123-code/gpu_design/docs/architecture.png

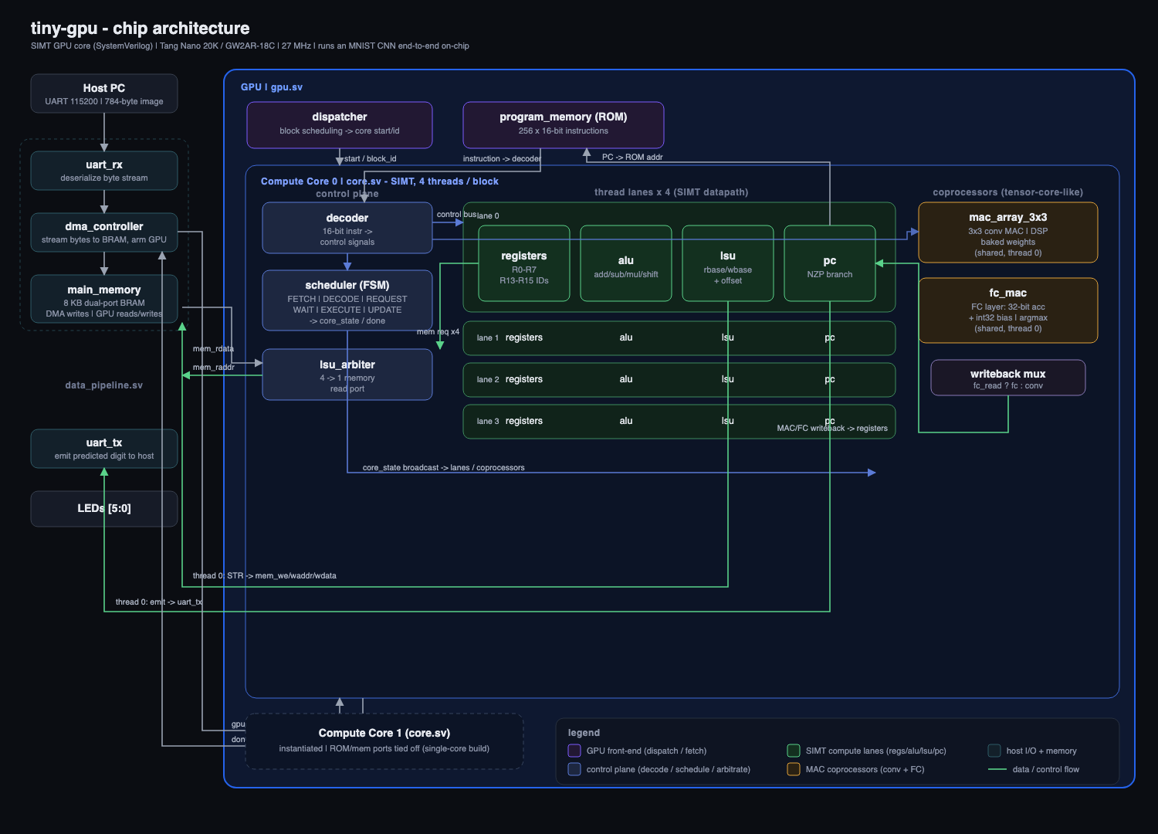
docs/architecture.png
