123-code/gpu_design/docs/core_detail.png

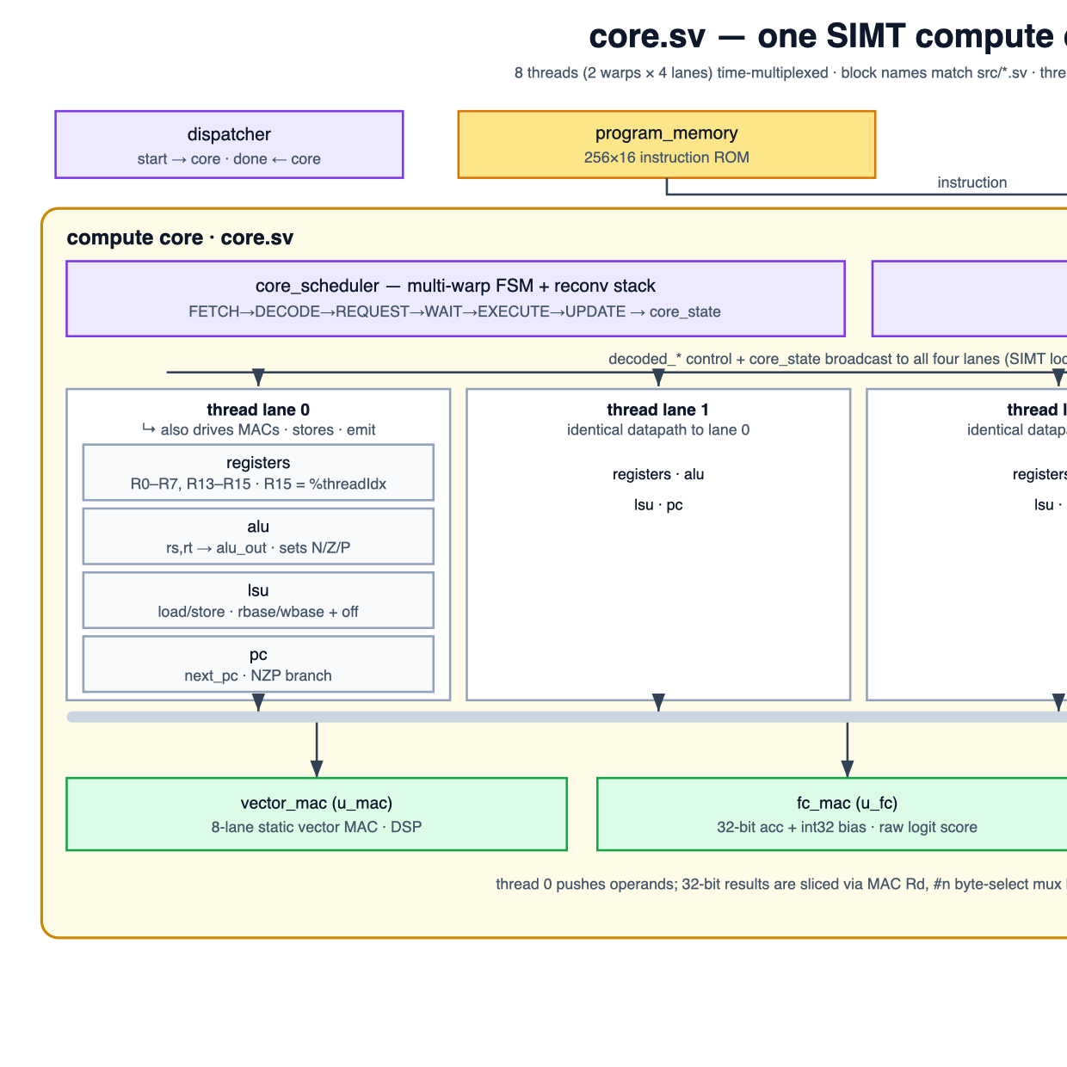
docs/core_detail.png
