123-code/gpu_design/docs/demo.png

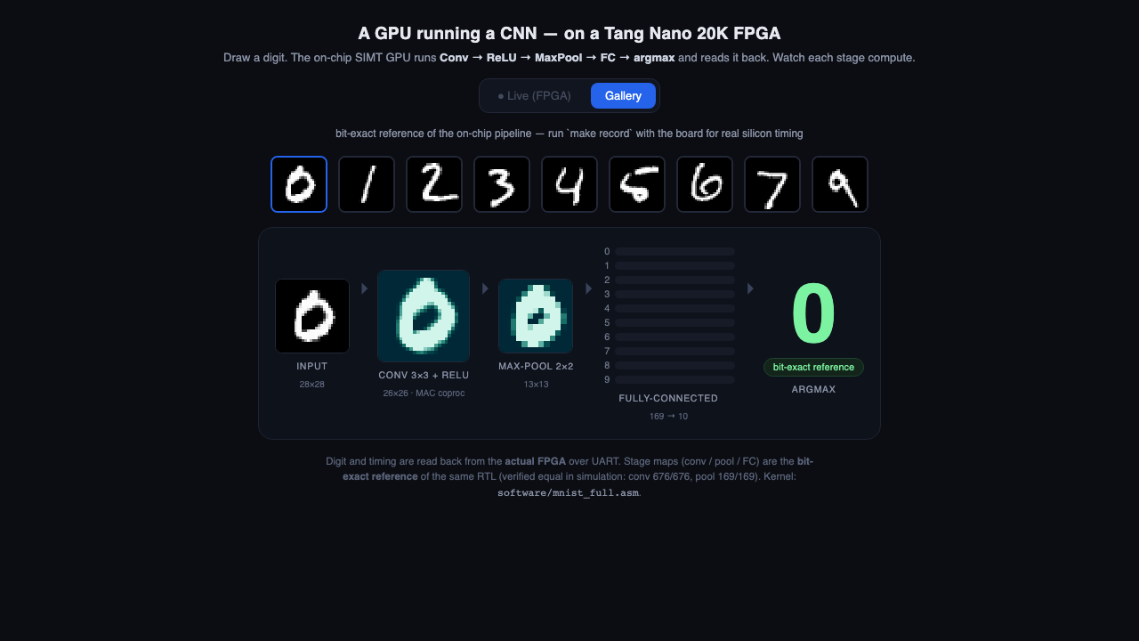
docs/demo.png
