123-code/gpu_design/docs/floorplan.svg.png

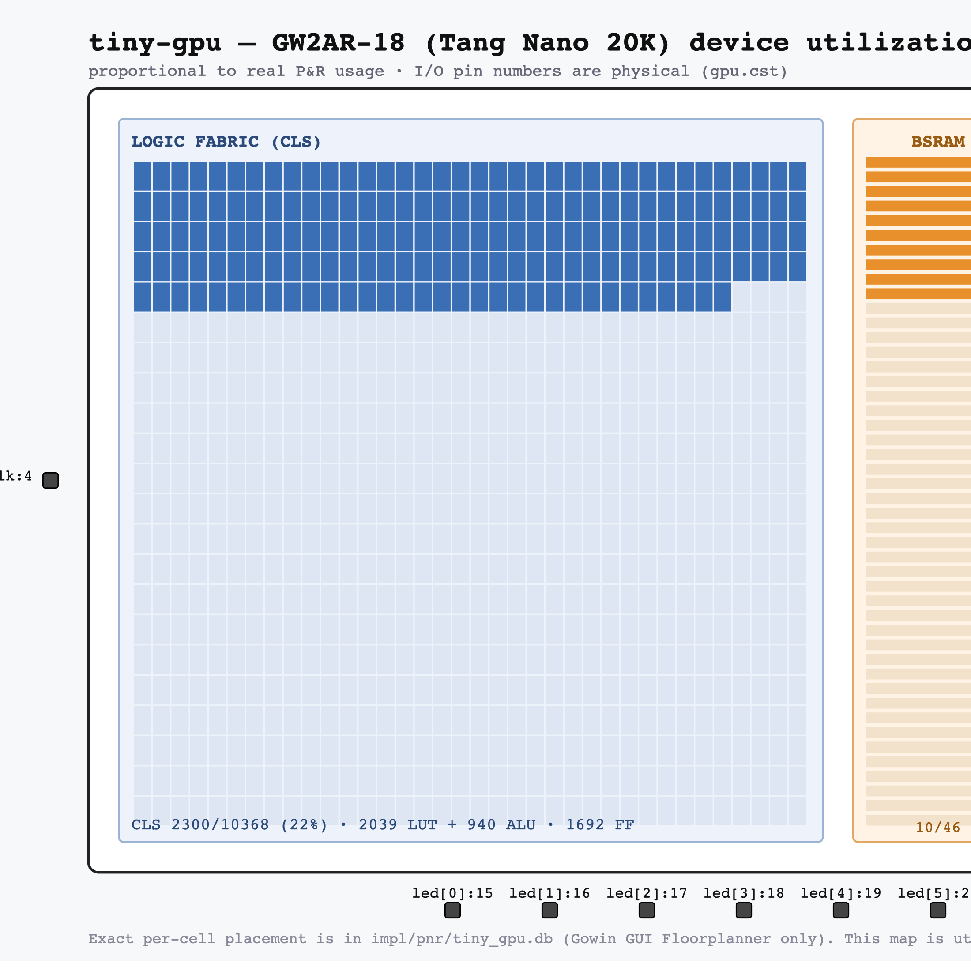
docs/floorplan.svg.png
