123-code/gpu_design/docs/gpu_overview.png

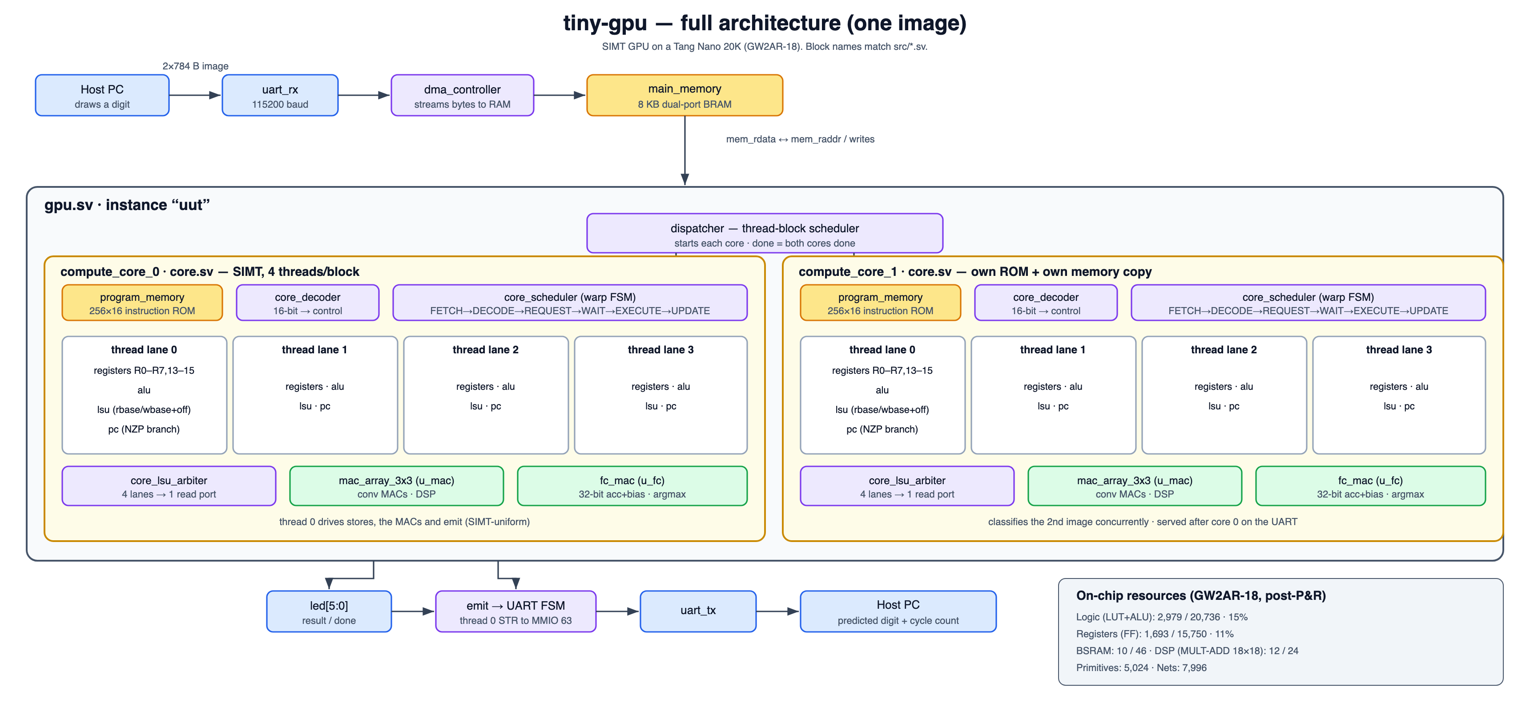
docs/gpu_overview.png
