123-code/gpu_design/docs/schematic/core_gates_flat.svg.png

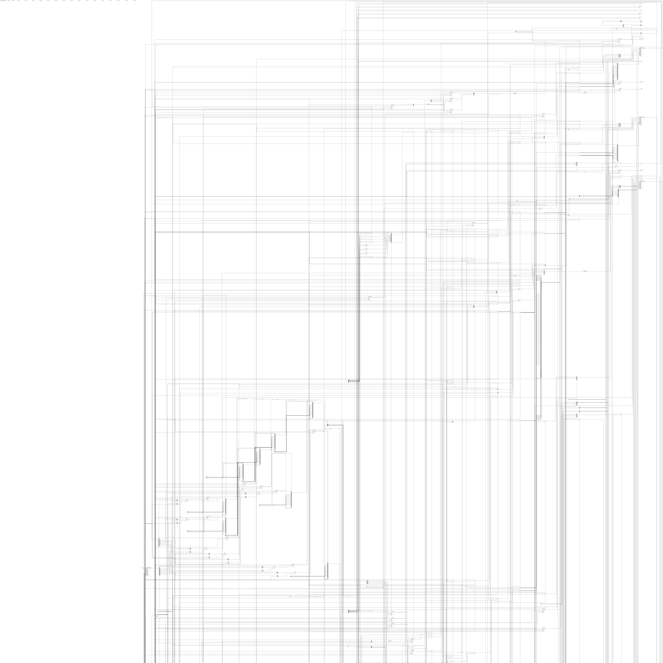
docs/schematic/core_gates_flat.svg.png
