123-code/gpu_design/docs/schematic/png/core.svg.png

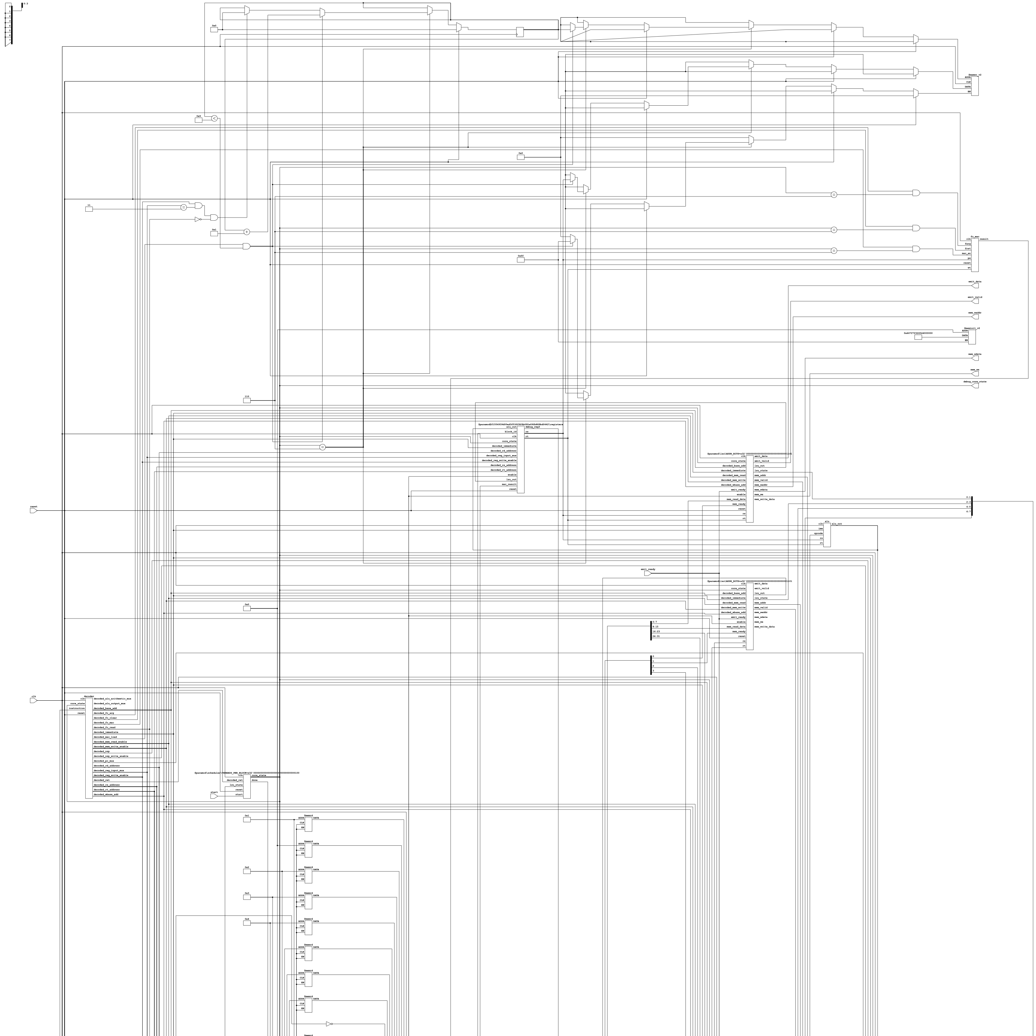
docs/schematic/png/core.svg.png
