123-code/gpu_design/docs/schematic/png/gate_alu.svg.png

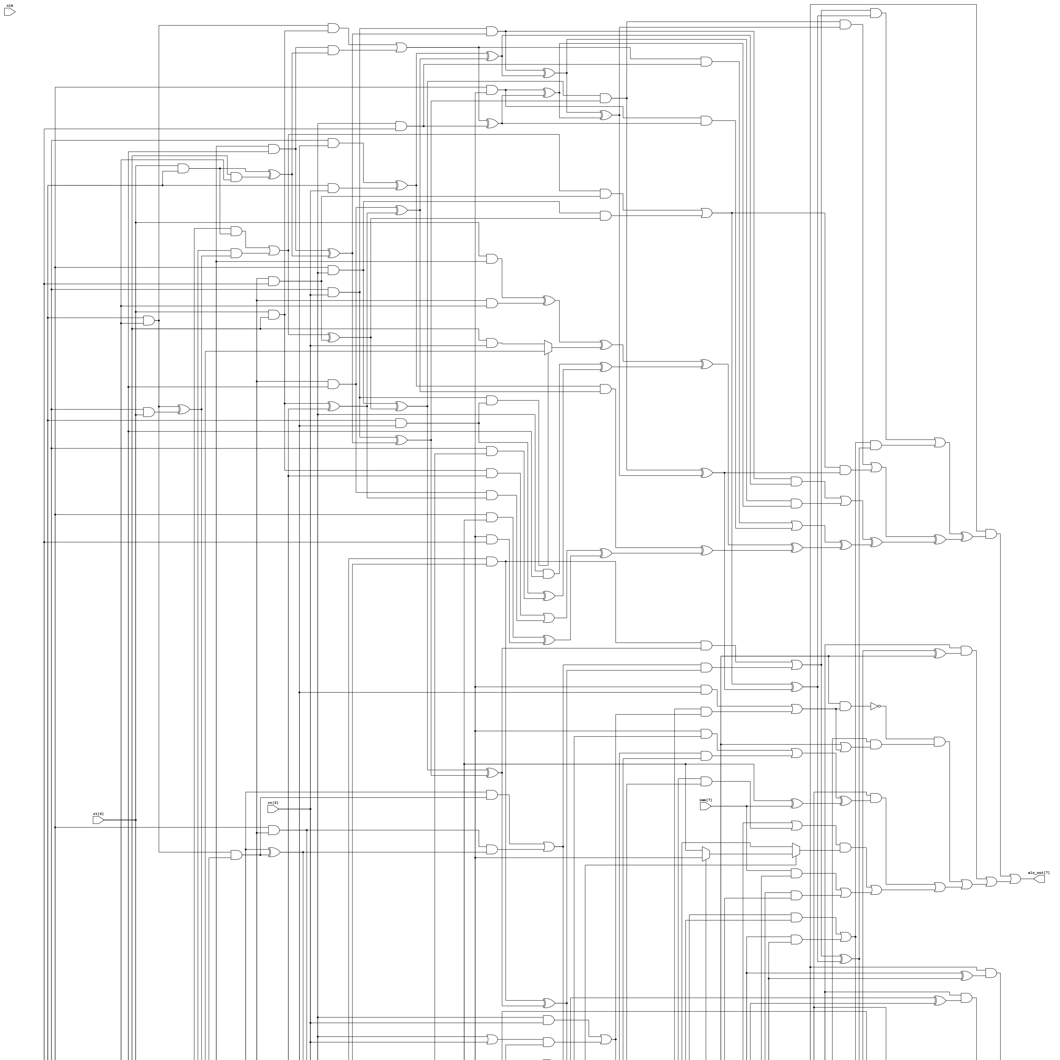
docs/schematic/png/gate_alu.svg.png
