123-code/gpu_design/docs/schematic/png/gate_pc.svg.png

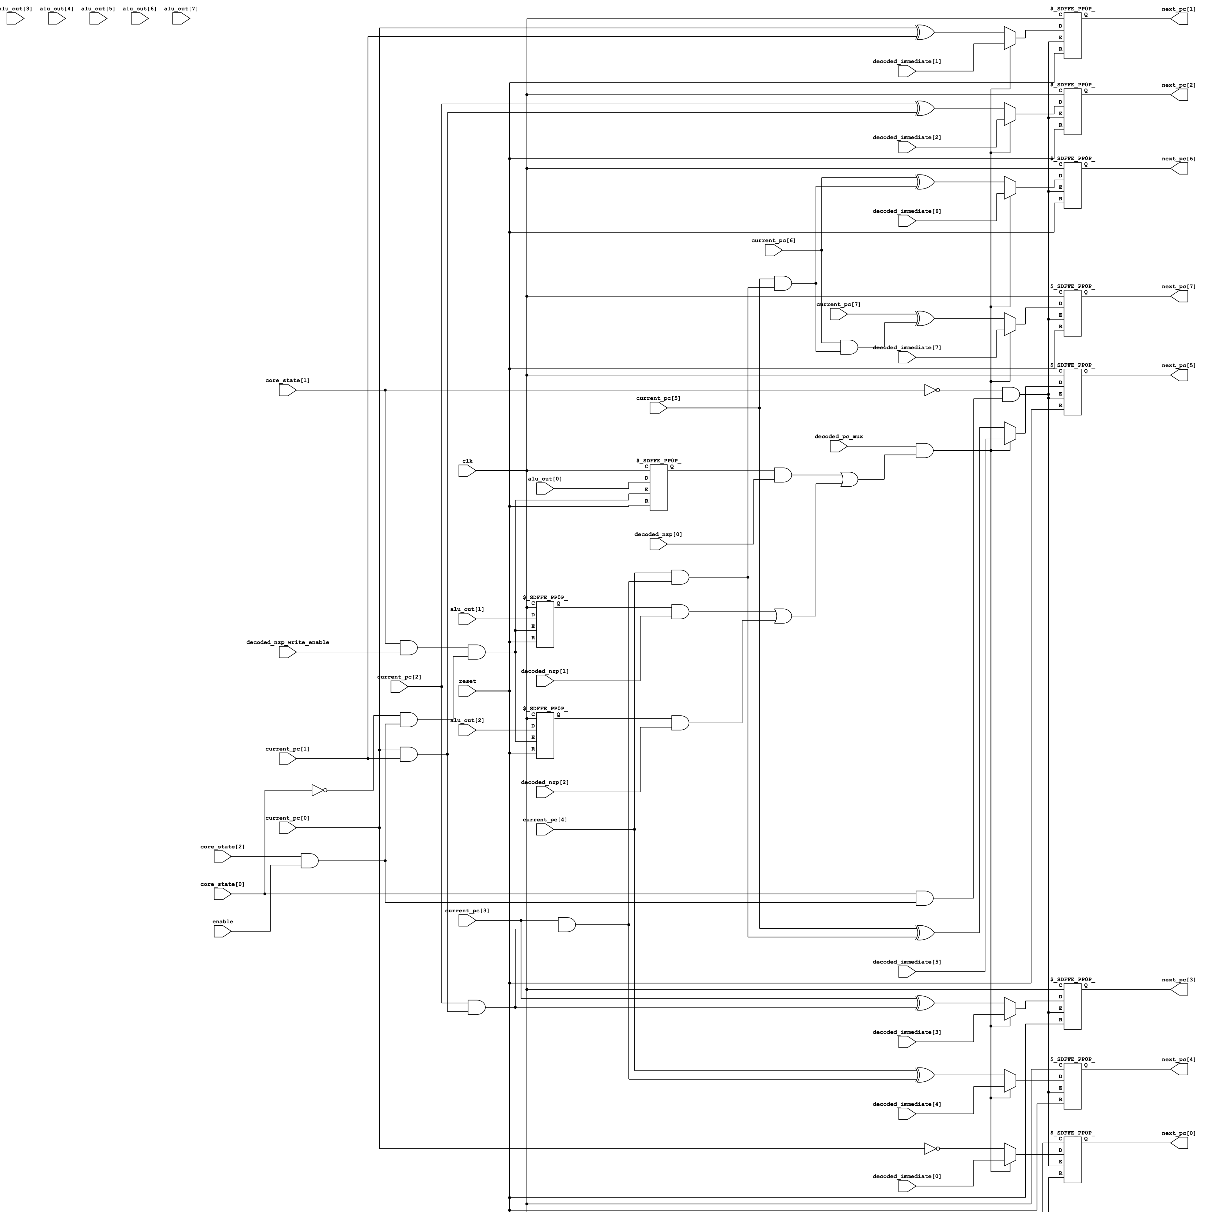
docs/schematic/png/gate_pc.svg.png
