123-code/gpu_design/docs/schematic/png/gate_scheduler.svg.png

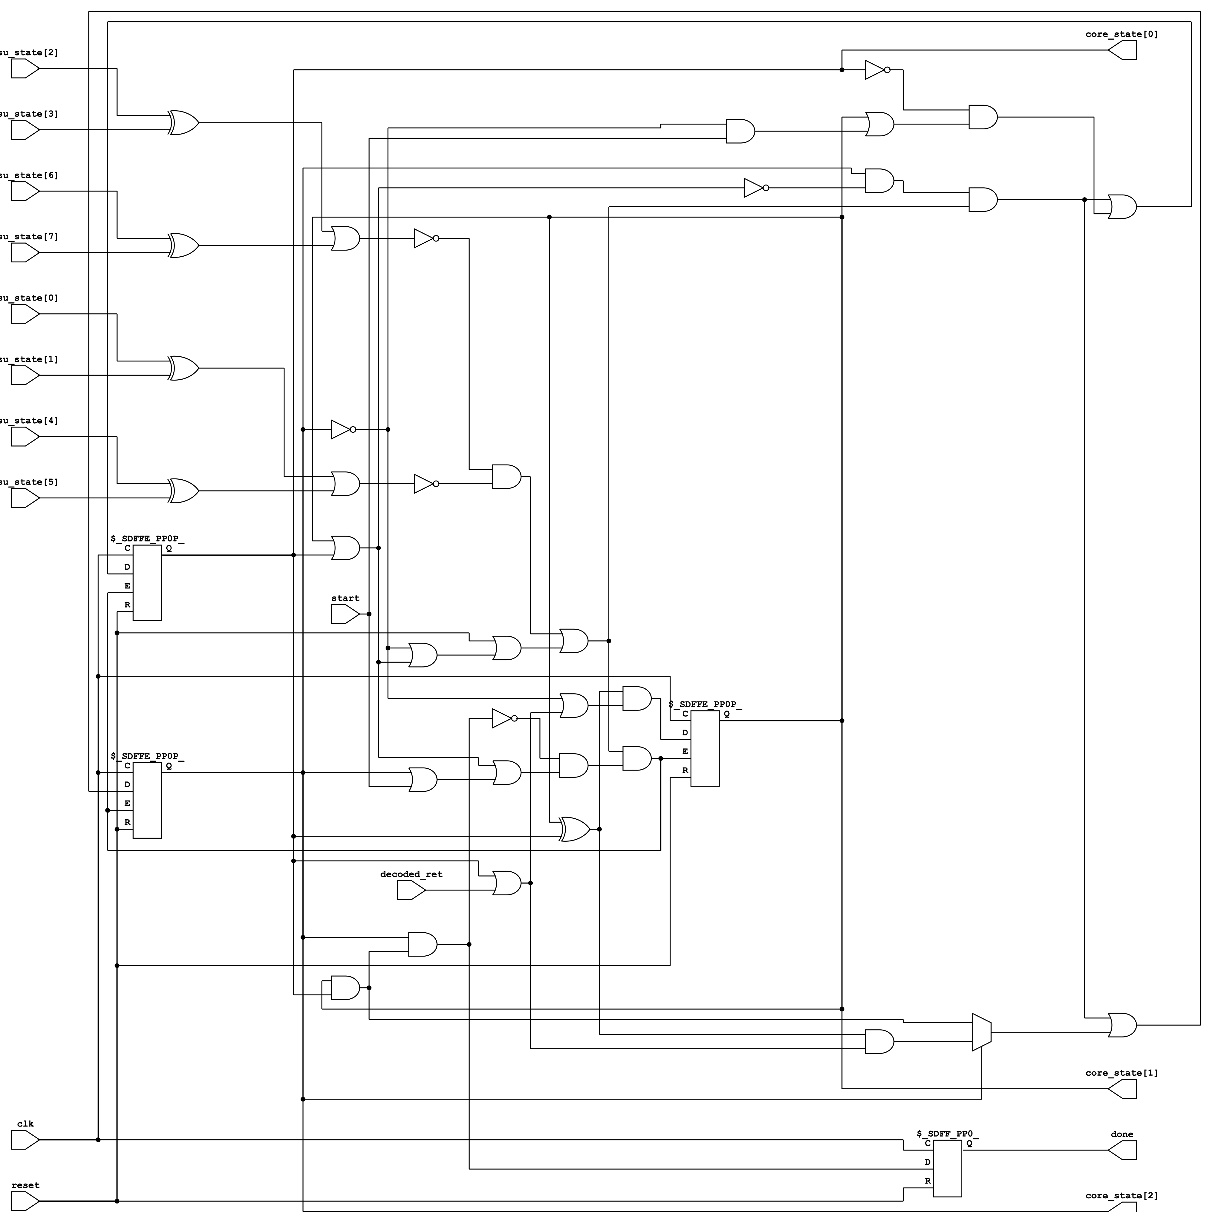
docs/schematic/png/gate_scheduler.svg.png
