123-code/gpu_design/docs/schematic/png/gpu.svg.png

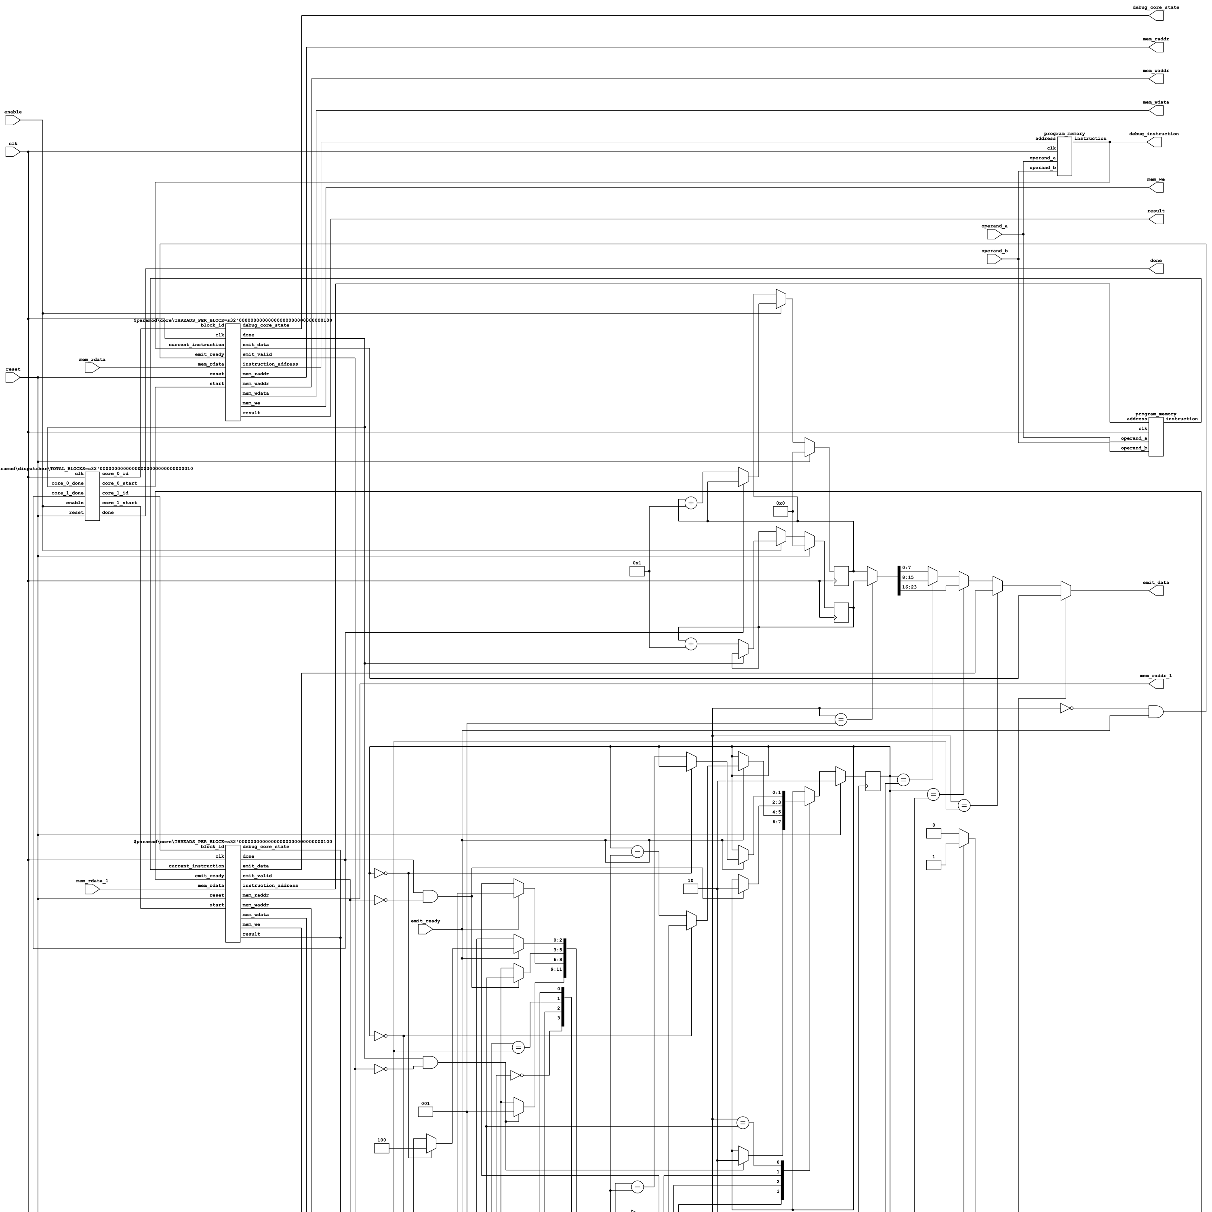
docs/schematic/png/gpu.svg.png
