123-code/gpu_design/docs/schematic/png/top.svg.png

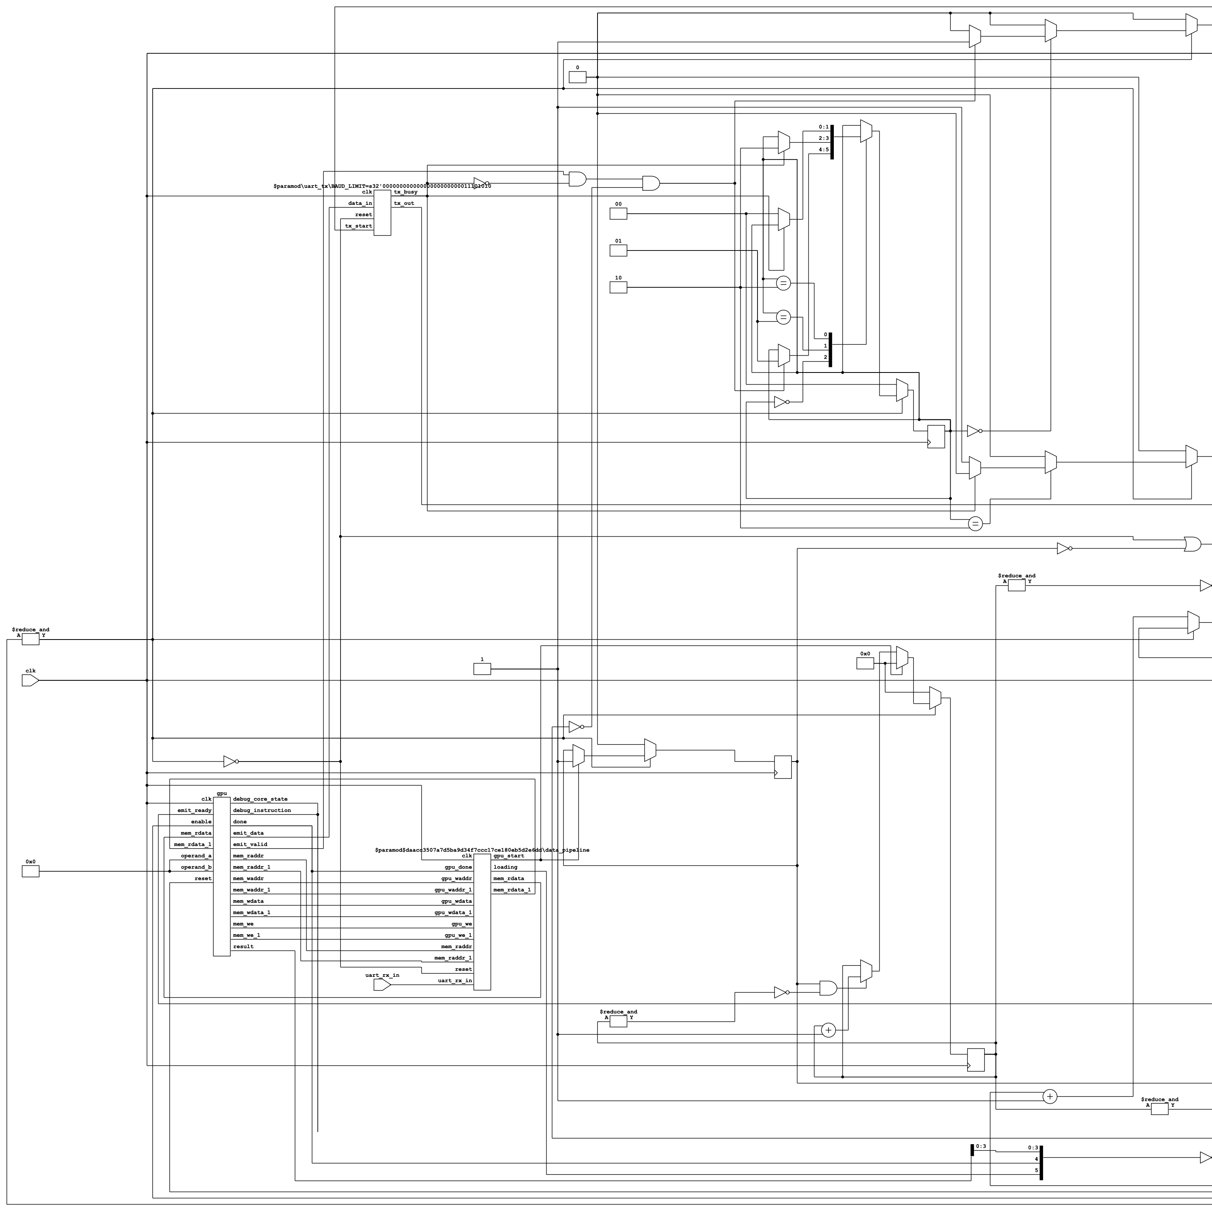
docs/schematic/png/top.svg.png
