123-code/gpu_design/src/main_memory.sv

`default_nettype none
`timescale 1ns/1ns

// Main data memory the GPU threads read from, and the DMA writes into.
// Simple dual-port BRAM: one write port (driven by the DMA while loading),
// one synchronous read port (driven by a thread's LSU). Gowin infers this as
// a semi-dual-port BSRAM. 1-cycle read latency.
module main_memory #(
    parameter ADDR_BITS     = 13,            // 4096 bytes: image + conv/FC weights +
                                         // GPU-computed conv/pool/score scratch.
                                         // Maps to ~2-4 BSRAM blocks (of 46).
    parameter DEPTH     = (1 << ADDR_BITS)
) (
    input  wire                 clk,

    // ---- write port (DMA) ----
    input  wire                 we,
    input  wire [ADDR_BITS-1:0] waddr,
    input  wire [7:0]           wdata,

    // ---- read port (GPU) ----
    input  wire [ADDR_BITS-1:0] raddr,
    output reg  [7:0]           rdata
);
    reg [7:0] mem [0:DEPTH-1];

    // NO baked model. This memory used to $readmemh 3380 bytes of interleaved
    // MNIST FC weights at synthesis time, which meant changing the network meant
    // re-synthesizing the bitstream -- the model was part of the hardware.
    //
    // Every weight now arrives over UART as data, planned and packed by the
    // compiler (software/src/bin/graph_compiler.rs). The bitstream is
    // model-independent. Nothing depended on the baked copy: each testbench
    // already streamed its own payload, and the DMA overwrote these addresses
    // before the kernel read them.

    always @(posedge clk) begin
        if (we) mem[waddr] <= wdata;     // DMA / GPU store
        rdata <= mem[raddr];             // synchronous read (1-cycle latency)
    end
endmodule
