123-code/gpu_design/src/decoder.sv

`default_nettype none
`timescale 1ns/1ns

module decoder #(
    parameter DATA_BITS = 16     // datapath width; sizes decoded_immediate
) (
    // ==========================================
    // PART 1: THE INPUT PINS (Wires coming IN)
    // ==========================================
    input wire clk,              // The heartbeat of the system (27MHz on the Tang Nano)
    input wire reset,            // The physical reset button/signal

    input wire [3:0] core_state,
    input wire [15:0] instruction,
    
    // ==========================================
    // PART 2: THE OUTPUT PINS (Wires going OUT)
    // ==========================================
    // Group A: Data Slices (routing chunks of the instruction to other places)
    output reg [3:0] decoded_rd_address,
    output reg [3:0] decoded_rs_address,
    output reg [3:0] decoded_rt_address,
    output reg [2:0] decoded_nzp,
    output reg [DATA_BITS-1:0] decoded_immediate,
    
    // Group B: Control Flags (1-bit boolean wires turning other components ON/OFF)
    output reg decoded_reg_write_enable,           
    output reg decoded_mem_read_enable,            
    output reg decoded_mem_write_enable,           
    output reg decoded_nzp_write_enable,           
    
    // Group C: Multiplexers (Multi-bit wires telling components HOW to behave)
    output reg [1:0] decoded_reg_input_mux,
    output reg [1:0] decoded_alu_arithmetic_mux,
    output reg decoded_alu_output_mux,
    output reg decoded_pc_mux,
    output reg decoded_ret,

    // MAC unit control: push an operand into the MAC buffer this instruction
    output reg decoded_mac_load,

    // Address unit: add decoded_immediate to the LSU read base this instruction
    output reg decoded_base_add,
    // ... or to the LSU write base (WBASE = ADDB with instruction[11] set)
    output reg decoded_wbase_add,

    // FC-MAC coprocessor control (opcode 0000 sub-functions)
    output reg decoded_fc_clear,   // FRST : reset the FC engine (acc/digit/best)
    output reg decoded_fc_mac,     // FMAC : acc += rs*rt
    output reg decoded_fc_arg,     // FARG : finalize current digit (add bias, argmax)
    output reg decoded_fc_read,    // FBEST: rd <- best_idx (uses the MAC writeback mux)
    output reg decoded_fc_acc,     // FACC : rd <- byte n of the raw accumulator
    output reg decoded_fc_out,     // FOUT : rd <- requantized+ReLU'd neuron output
    output reg [2:0] decoded_fc_shift, // FOUT : extra right shift beyond 8

    // Which 8-bit slice of the 32-bit MAC/FC result to write back (MAC Rd,#n).
    // 0 = [7:0] (LSB) ... 3 = [31:24] (MSB). 0 for every non-MAC instruction.
    output reg [1:0] decoded_mac_byte,

    // identity register (R15/R13/R14) into rd. The selector reuses the rs field
    // (decoded_rs_address): 1->threadIdx, 2->blockIdx, 3->blockDim.
    output reg decoded_id_read,

    // LUI (MOV-variant, rs field == 4): Rd = (Rd << 6) | imm6. Lets software build
    // a full 16-bit constant in 3 ops (MOV top4 + LUI mid6 + LUI low6). Computed in
    // the register file (no ALU/opcode change); the decoder points rs at Rd so the
    // regfile latches the old Rd to shift.
    output reg decoded_lui,
    
    // Pop the reconvergence stack and switch to sleeping threads
    output reg decoded_sync
);

    // Human-readable labels for the physical 4-bit Opcode wire combinations
    localparam FCU  = 4'b0000; // FC-MAC coprocessor; sub-function in instruction[5:4]
    localparam ADD  = 4'b0001;
    localparam MOV  = 4'b0010;
    localparam CMP  = 4'b0011;
    localparam LDR  = 4'b0100;
    localparam ADDI = 4'b0101;
    localparam MUL  = 4'b1010; // general arithmetic primitives (rd = rs op rt)
    localparam SHR  = 4'b1100;
    localparam SHL  = 4'b1101;
    localparam SUB  = 4'b1110;
    localparam MACL = 4'b0110; // push a register into the MAC operand buffer
    localparam MAC  = 4'b0111; // fire the MAC, write result to rd
    localparam BRn  = 4'b1000;
    localparam ADDB = 4'b1001; // base += immediate (data-memory base pointer)
    localparam STR  = 4'b1011; // store/emit: write rt to [rs] (MMIO TX when rs==63)
    localparam RET  = 4'b1111;

    // decoded_reg_input_mux selectors (must match registers.sv)
    localparam MUX_ARITHMETIC = 2'b00;
    localparam MUX_MEMORY     = 2'b01;
    localparam MUX_CONSTANT   = 2'b10;
    localparam MUX_MAC        = 2'b11;

    // ==========================================
    // PART 3: THE INTERNAL LOGIC MACHINERY
    // ==========================================
    // This block tells the hardware: "Every time the 'clk' pin voltage goes from LOW to HIGH, do this."
    always @(posedge clk) begin 
        
        // If the reset pin is triggered, turn all output wires OFF (0 Volts)
        if (reset) begin
            decoded_rd_address <= 0;
            decoded_rs_address <= 0;
            decoded_rt_address <= 0;
            decoded_nzp <= 0;
            decoded_immediate <= 0;

            decoded_reg_write_enable <= 0;
            decoded_mem_read_enable <= 0;
            decoded_mem_write_enable <= 0;
            decoded_nzp_write_enable <= 0;

            decoded_reg_input_mux <= 0;
            decoded_alu_arithmetic_mux <= 0;
            decoded_alu_output_mux <= 0;
            decoded_pc_mux <= 0;
            decoded_ret <= 0;
            decoded_mac_load <= 0;
            decoded_base_add <= 0;
            decoded_wbase_add <= 0;
            decoded_fc_clear <= 0;
            decoded_fc_mac <= 0;
            decoded_fc_arg <= 0;
            decoded_fc_read <= 0;
            decoded_fc_acc <= 0;
            decoded_fc_out <= 0;
            decoded_fc_shift <= 0;
            decoded_mac_byte <= 0;
            decoded_id_read <= 0;
            decoded_lui <= 0;
            decoded_sync <= 0;

        end else begin
            // Only decode in the DECODE stage (4-bit state = 0011)
            if (core_state == 4'b0011) begin
                
                // --- THE BIT SLICER ---
                // Physically branching wires from the 16-lane 'instruction' bus to the output pins

                // Grabbing exactly 3 bits for registers to match the assembler ISA
                decoded_rd_address <= {1'b0, instruction[11:9]}; // dest  -> [11:9]
                decoded_rs_address <= {1'b0, instruction[8:6]};  // src1  -> [8:6]
                decoded_rt_address <= {1'b0, instruction[2:0]};  // src2  -> [2:0]

                // The immediate payload is the bottom 6 bits (assembler emits 6-bit imm)
                decoded_immediate  <= {{(DATA_BITS-6){1'b0}}, instruction[5:0]};
                decoded_nzp        <= instruction[11:9];

                // Reset control wires to 0 before the switch logic applies.
                // Every strobe must be cleared here, or a flag set by one
                // instruction (e.g. pc_mux on BRn) would stick on the next one.
                decoded_reg_write_enable <= 0;
                decoded_mem_read_enable  <= 0;
                decoded_mem_write_enable <= 0;
                decoded_nzp_write_enable <= 0;
                decoded_alu_arithmetic_mux <= 0;
                decoded_alu_output_mux <= 0;
                decoded_reg_input_mux <= 0;
                decoded_pc_mux <= 0;
                decoded_ret <= 0;
                decoded_mac_load <= 0;
                decoded_base_add <= 0;
            decoded_wbase_add <= 0;
                decoded_fc_clear <= 0;
                decoded_fc_mac <= 0;
                decoded_fc_arg <= 0;
                decoded_fc_read <= 0;
                decoded_fc_acc <= 0;
                decoded_fc_out <= 0;
                decoded_fc_shift <= 0;
                decoded_mac_byte <= 0;
                decoded_id_read <= 0;
                decoded_lui <= 0;
                decoded_sync <= 0;

                // --- THE OPCODE SWITCH ---
                // Look at the top 4 wires of the instruction (bits 15, 14, 13, 12)
                case (instruction[15:12])
                    FCU: begin
                        // FC-MAC coprocessor. Sub-function in instruction[5:4]:
                        //   00 FRST  -> reset the FC engine
                        //   01 FMAC  -> acc += rs*rt          (rs=[8:6], rt=[2:0])
                        //   10 FARG  -> finalize digit (add bias, argmax)
                        //   11 FBEST -> rd <- best_idx via the MAC writeback mux
                        case (instruction[5:4])
                            2'b00: decoded_fc_clear <= 1;
                            2'b01: decoded_fc_mac   <= 1;
                            2'b10: begin
                                // instruction[3] splits this slot:
                                //   0 = FARG (finalize a CLASSIFIER digit: add
                                //       bias, argmax, clear acc)
                                //   1 = FOUT (finalize a HIDDEN neuron: shift,
                                //       clamp, ReLU into rd, clear acc)
                                if (instruction[3]) begin
                                    decoded_fc_out           <= 1;
                                    decoded_fc_shift         <= instruction[2:0];
                                    decoded_reg_write_enable <= 1;
                                    decoded_reg_input_mux    <= MUX_MAC;
                                    decoded_fc_read          <= 1;
                                end else begin
                                    decoded_fc_arg           <= 1;
                                end
                            end
                            2'b11: begin
                                // Read the FC unit back into rd. instruction[3]
                                // selects WHAT: 0 = best_idx (FBEST, the legacy
                                // encoding, low bits all zero), 1 = the raw 32-bit
                                // accumulator (FACC). instruction[1:0] selects
                                // which byte, reusing the MAC byte-select mux.
                                decoded_reg_write_enable <= 1;
                                decoded_reg_input_mux    <= MUX_MAC;
                                decoded_fc_read          <= 1;
                                decoded_fc_acc           <= instruction[3];
                                decoded_mac_byte         <= instruction[1:0];
                            end
                        endcase
                    end
                    ADD: begin
                        // rs + rt -> rd
                        decoded_reg_write_enable <= 1;
                    end
                    ADDI: begin
                        // rs + immediate -> rd (ALU selects imm via the opcode)
                        decoded_reg_write_enable <= 1;
                    end
                    MUL, SUB, SHR, SHL: begin
                        // General ALU ops: rd = rs (op) rt, written via ARITHMETIC mux
                        decoded_reg_write_enable <= 1;
                    end
                    MOV: begin
                        decoded_reg_write_enable <= 1;
                        // rs field ([8:6]) selects the MOV variant:
                        //   0       plain MOV: load imm6
                        //   1/2/3   TID/BID/BDIM: copy identity reg R15/R13/R14 into rd
                        //   4       LUI: Rd = (Rd<<6)|imm6 (point rs at Rd to read it)
                        case (instruction[8:6])
                            3'b000: ; // plain MOV, load immediate
                            3'b100: begin
                                decoded_lui <= 1;
                                decoded_rs_address <= {1'b0, instruction[11:9]}; // read old Rd
                            end
                            default: decoded_id_read <= 1; // 1/2/3 identity reads
                        endcase
                    end
                    CMP: begin
                        // Compares don't save to registers; they save N/Z/P flags.
                        decoded_reg_write_enable <= 0;
                        decoded_nzp_write_enable <= 1; // tell pc.sv to latch the flags
                        decoded_alu_output_mux   <= 1; // ALU emits flags, not a number
                    end
                    LDR: begin
                        // Load: read from memory, then write the result back to rd
                        decoded_reg_write_enable <= 1;
                        decoded_mem_read_enable  <= 1;
                        decoded_reg_input_mux    <= MUX_MEMORY;
                    end
                    MACL: begin
                        // Push rs into the MAC operand buffer (no register write)
                        decoded_mac_load <= 1;
                    end
                    MAC: begin
                        // Fire the MAC and write the selected byte of its 32-bit
                        // result into rd. instruction[1:0] picks the byte
                        // (MAC Rd,#n); bare MAC Rd encodes #0 = low byte.
                        decoded_reg_write_enable <= 1;
                        decoded_reg_input_mux    <= MUX_MAC;
                        decoded_mac_byte         <= instruction[1:0];
                    end
                    BRn: begin
                        // Branch: tell pc.sv to route the jump target into the PC
                        // (gated by the saved N/Z/P flags vs decoded_nzp). The target
                        // is 8-bit (instruction[7:0]) so it can reach the whole 256-word
                        // ROM, not just the low 64 the generic 6-bit immediate allows.
                        decoded_pc_mux   <= 1;
                        decoded_immediate <= instruction[7:0];
                    end
                    ADDB: begin
                        // Advance a data-memory base pointer by the immediate.
                        // instruction[11] picks which: 0 = read base (ADDB),
                        // 1 = write base (WBASE).
                        if (instruction[11]) decoded_wbase_add <= 1;
                        else                 decoded_base_add  <= 1;
                    end
                    STR: begin
                        // Store/emit: the LSU writes rt to the address in rs
                        // (rs == 63 routes to the memory-mapped UART TX).
                        decoded_mem_write_enable <= 1;
                    end
                    RET: begin 
                        if (instruction[0] == 1'b1) begin
                            decoded_sync <= 1;
                        end else begin
                            decoded_ret <= 1;                     
                        end
                    end
                endcase
            end
        end
    end
endmodule
