123-code/gpu_design/software/mnist_jpp.asm

// y -> R0
MOV R0, #0
// x -> R1
MOV R1, #0
// c -> R2
MOV R2, #0
// g1 -> R3
MOV R3, #0
// g2 -> R4
MOV R4, #0
// g3 -> R5
MOV R5, #0
WBASE #63
WBASE #63
WBASE #63
WBASE #63
WBASE #63
WBASE #63
WBASE #63
WBASE #63
WBASE #63
WBASE #63
WBASE #63
WBASE #63
WBASE #28
Lcond1:
MOV R6, #26
CMP R0, R6
BRzp Lend1
MOV R1, #0
Lcond2:
MOV R6, #26
CMP R1, R6
BRzp Lend2
TID R6
ADD R2, R1, R6
ADDI R6, R2, #56
LDR R6, [R6]
LDI R7, #127
MUL R3, R6, R7
ADDI R6, R2, #57
LDR R6, [R6]
LDI R7, #127
MUL R6, R6, R7
ADD R3, R3, R6
ADDI R6, R2, #29
LDR R6, [R6]
LDI R7, #101
MUL R4, R6, R7
LDR R6, [R2]
LDI R7, #95
MUL R6, R6, R7
ADD R4, R4, R6
ADDI R6, R2, #30
LDR R6, [R6]
MOV R7, #50
MUL R6, R6, R7
ADD R4, R4, R6
ADDI R6, R2, #58
LDR R6, [R6]
LDI R7, #70
MUL R5, R6, R7
ADDI R6, R2, #28
LDR R6, [R6]
LDI R7, #68
MUL R6, R6, R7
ADD R5, R5, R6
ADDI R6, R2, #1
LDR R6, [R6]
MOV R7, #27
MUL R6, R6, R7
ADD R5, R5, R6
MOV R6, #8
SHR R6, R3, R6
MOV R7, #8
SHR R7, R4, R7
ADD R6, R6, R7
MOV R7, #8
SHR R7, R5, R7
ADD R2, R6, R7
ADD R6, R3, R4
ADD R6, R6, R5
MOV R7, #8
SHL R7, R2, R7
SUB R3, R6, R7
MOV R6, #8
SHR R6, R3, R6
ADD R2, R2, R6
LDI R6, #255
CMP R6, R2
BRzp Lskip3
LDI R2, #255
Lskip3:
SYNC
TID R6
ADD R6, R1, R6
STR R2, [R6]
BDIM R6
ADD R1, R1, R6
BR Lcond2
Lend2:
ADDB #28
WBASE #26
ADDI R0, R0, #1
BR Lcond1
Lend1:
ADDB #56
MOV R0, #0
Lcond4:
MOV R6, #13
CMP R0, R6
BRzp Lend4
MOV R1, #0
Lcond5:
MOV R6, #13
CMP R1, R6
BRzp Lend5
TID R6
ADD R2, R1, R6
ADD R3, R2, R2
LDR R6, [R3]
ADDI R7, R3, #1
LDR R7, [R7]
CMP R7, R6
BRn Lmax6
ADDI R6, R7, #0
Lmax6:
SYNC
ADDI R4, R6, #0
ADDI R6, R3, #26
LDR R6, [R6]
CMP R4, R6
BRn Lmax7
ADDI R6, R4, #0
Lmax7:
SYNC
ADDI R4, R6, #0
ADDI R6, R3, #27
LDR R6, [R6]
CMP R4, R6
BRn Lmax8
ADDI R6, R4, #0
Lmax8:
SYNC
ADDI R4, R6, #0
STR R4, [R2]
BDIM R6
ADD R1, R1, R6
BR Lcond5
Lend5:
ADDB #52
WBASE #13
ADDI R0, R0, #1
BR Lcond4
Lend4:
TID R6
MOV R7, #0
CMP R6, R7
BRnp Lskip9
FRST
MOV R0, #0
LDI R2, #201
Lcond10:
MOV R6, #10
CMP R0, R6
BRzp Lend10
MOV R1, #0
Lcond11:
LDI R6, #169
CMP R1, R6
BRzp Lend11
LDR R6, [R1]
LDR R7, [R2]
FMAC R6, R7
ADDI R1, R1, #1
ADDI R2, R2, #1
BR Lcond11
Lend11:
FARG
ADDI R0, R0, #1
BR Lcond10
Lend10:
FBEST R0
MOV R6, #63
STR R0, [R6]
Lskip9:
SYNC
RET
RET
