123-code/gpu_design/drills/solutions/01_counter.sv

module counter (
    input  logic       clk,
    input  logic       rst,
    input  logic       en,
    output logic [7:0] count
);
    always_ff @(posedge clk) begin
        if (rst)     count <= '0;
        else if (en) count <= count + 1'b1;
    end
endmodule
