123-code/gpu_design/software/conv_full.asm

MOV R1, #0
LDR R5, [R1]
MACL R5
MOV R1, #1
LDR R5, [R1]
MACL R5
MOV R1, #2
LDR R5, [R1]
MACL R5
MOV R1, #3
LDR R5, [R1]
MACL R5
MOV R1, #4
LDR R5, [R1]
MACL R5
MOV R1, #5
LDR R5, [R1]
MACL R5
MOV R1, #6
LDR R5, [R1]
MACL R5
MOV R1, #7
LDR R5, [R1]
MACL R5
MOV R1, #8
LDR R5, [R1]
MACL R5
MOV R1, #0
LDR R5, [R1]
MACL R5
MOV R1, #1
LDR R5, [R1]
MACL R5
MOV R1, #2
LDR R5, [R1]
MACL R5
MOV R1, #3
LDR R5, [R1]
MACL R5
MOV R1, #4
LDR R5, [R1]
MACL R5
MOV R1, #5
LDR R5, [R1]
MACL R5
MOV R1, #6
LDR R5, [R1]
MACL R5
MOV R1, #7
LDR R5, [R1]
MACL R5
MOV R1, #8
LDR R5, [R1]
MACL R5
MAC R3
ADDB #9
MOV R7, #0
MOV R6, #0
MOV R1, #0
LDR R5, [R1]
MACL R5
MOV R1, #1
LDR R5, [R1]
MACL R5
MOV R1, #2
LDR R5, [R1]
MACL R5
MOV R1, #28
LDR R5, [R1]
MACL R5
MOV R1, #29
LDR R5, [R1]
MACL R5
MOV R1, #30
LDR R5, [R1]
MACL R5
MOV R1, #56
LDR R5, [R1]
MACL R5
MOV R1, #57
LDR R5, [R1]
MACL R5
MOV R1, #58
LDR R5, [R1]
MACL R5
MAC R3
MOV R1, #63
STR R3, [R1]
ADDB #1
ADD R6, R6, #1
MOV R2, #26
CMP R6, R2
BRn 58
ADDB #2
ADD R7, R7, #1
MOV R2, #26
CMP R7, R2
BRn 57
RET
