123-code/gpu_design/test/tb_divmerge.sv

`default_nettype none
`timescale 1ns/1ns

// ============================================================================
// Branch divergence + RECONVERGENCE validation.
//
// Loads software/divmerge_kernel.asm: a divergent diamond followed by common
// code that every lane must run after the paths merge back.
//     lanes 0,1 (threadIdx<2) -> branch path -> R3 = 10
//     lanes 2,3 (threadIdx>=2) -> stay path   -> R3 = 20      (divergence)
//     then ALL lanes:           R4 = 7                        (reconvergence)
//
// Correct: R3 = [10,10,20,20] and R4 = [7,7,7,7]. The reconvergence half fails
// if the divergence stack doesn't restore the pre-divergence mask when it
// empties (the branch lanes would stay masked off through the common code, so
// R4 = [0,0,7,7]). Per-lane registers are read by hierarchical reference.
// ============================================================================
module tb;
    localparam PROG_WORDS = 10;          // software/divmerge_kernel.hex length
    localparam BIT_CYCLES = 16;

    reg  clk = 0;
    reg  uart_line = 1'b1;
    wire uart_tx;
    wire [5:0] led;

    top #(.PAYLOAD_BYTES(1), .CLK_FREQ(BIT_CYCLES), .BAUD_RATE(1)) dut (
        .clk(clk), .uart_rx_in(uart_line), .uart_tx_out(uart_tx), .led(led));

    always #5 clk = ~clk;

    reg [15:0] prog [0:PROG_WORDS-1];

    task uart_send(input [7:0] b);
        integer k;
        begin
            uart_line = 1'b0;
            repeat (BIT_CYCLES) @(posedge clk);
            for (k = 0; k < 8; k = k + 1) begin
                uart_line = b[k];
                repeat (BIT_CYCLES) @(posedge clk);
            end
            uart_line = 1'b1;
            repeat (BIT_CYCLES) @(posedge clk);
        end
    endtask

    function [7:0] r3(input integer lane);
        case (lane)
            0: r3 = dut.uut.compute_core_0.warp_block[0].thread_block[0].thread_regs.registers[3];
            1: r3 = dut.uut.compute_core_0.warp_block[0].thread_block[1].thread_regs.registers[3];
            2: r3 = dut.uut.compute_core_0.warp_block[0].thread_block[2].thread_regs.registers[3];
            default: r3 = dut.uut.compute_core_0.warp_block[0].thread_block[3].thread_regs.registers[3];
        endcase
    endfunction
    function [7:0] r4(input integer lane);
        case (lane)
            0: r4 = dut.uut.compute_core_0.warp_block[0].thread_block[0].thread_regs.registers[4];
            1: r4 = dut.uut.compute_core_0.warp_block[0].thread_block[1].thread_regs.registers[4];
            2: r4 = dut.uut.compute_core_0.warp_block[0].thread_block[2].thread_regs.registers[4];
            default: r4 = dut.uut.compute_core_0.warp_block[0].thread_block[3].thread_regs.registers[4];
        endcase
    endfunction

    integer i, fails, timeout;
    reg [7:0] exp [0:3];
    initial begin
        $readmemh("/Users/joseignacio/tiny-gpu-fpga/software/divmerge_kernel.hex", prog);
        exp[0] = 8'd10; exp[1] = 8'd10; exp[2] = 8'd20; exp[3] = 8'd20;

        repeat (64) @(posedge clk);

        uart_send(PROG_WORDS % 256); uart_send(PROG_WORDS / 256);
        uart_send(8'd0);             uart_send(8'd0);
        for (i = 0; i < PROG_WORDS; i = i + 1) begin
            uart_send(prog[i][7:0]);
            uart_send(prog[i][15:8]);
        end

        timeout = 0;
        while (dut.uut.core_0_done !== 1'b1 && timeout < 200000) begin
            @(posedge clk); timeout = timeout + 1;
        end
        repeat (4) @(posedge clk);

        if (dut.uut.core_0_done !== 1'b1) begin
            $display("RESULT: FAIL - core never finished (timeout)");
            $finish;
        end

        fails = 0;
        for (i = 0; i < 4; i = i + 1) begin
            $display("  lane %0d: R3 = %0d (expect %0d, divergence)   R4 = %0d (expect 7, reconverge)",
                     i, r3(i), exp[i], r4(i));
            if (r3(i) !== exp[i]) fails = fails + 1;
            if (r4(i) !== 8'd7)   fails = fails + 1;
        end

        if (fails == 0)
            $display("RESULT: PASS - divergence AND reconvergence correct (R3=[10,10,20,20], R4=[7,7,7,7])");
        else
            $display("RESULT: FAIL - %0d check(s) wrong", fails);
        $finish;
    end

    initial begin
        repeat (2000000) @(posedge clk);
        $display("RESULT: FAIL - global timeout");
        $finish;
    end
endmodule
