123-code/gpu_design/(commit log)

2026-05-29 tiny-gpu: SystemVerilog GPU core + Rust assembler, simulated and flashed to Tang Nano 20K
    Working single-core SIMT datapath that runs a 5*3 multiply kernel:
    - RTL: gpu/core/scheduler/decoder/registers/alu/pc/lsu (src/)
    - Rust assembler with ADD/ADDI/MOV/CMP/BRn/RET (software/)
    - Self-checking testbench: verifies R3=15 and core reaches DONE (test/)
    - Gowin build + flash scripts for macOS, Tang Nano 20K constraints (src/gpu.cst/.sdc)
    - Hardware bring-up diagnostics: clock blink + slow-clock FSM viewer (diag/)
    LED demo shows done + result (1111 = 15). GPU clocked at ~13 kHz on hardware;
    power-on reset only (board S1 button left unused).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
    [alu.sv, blink.sv, core.sv, decoder.sv, dispatcher.sv, gpu.sv, gpu_slow.sv]
2026-05-29 Add UART result reporting (115200 8N1) and sync from board build
    - uart_tx.sv: 8N1 UART transmitter (BAUD_LIMIT=234 @ 27 MHz ~= 115200)
    - top.sv: transmit R3 as ASCII decimal + CRLF over UART, re-sent ~every 0.6s;
    done synchronized into the 27 MHz domain (2-FF + edge-detect CDC) and driven
    by a small message-sender FSM
    - gpu.cst: constrain uart_tx_out to PIN 69 (Tang Nano 20K onboard USB-serial)
    - README: document serial output
    Verified on hardware: laptop receives "015\r\n" (=15) repeating.
2026-05-30 Add UART receiver: send two operands from laptop, GPU multiplies, replies
    Laptop -> FPGA -> laptop round trip over the onboard USB-serial bridge:
    - uart_rx.sv: 8N1 receiver (mid-bit sample), rx_byte + rx_valid
    - top.sv: ASCII decimal parser ("A<sep>B<Enter>"), operand latches (default 5/3),
    toggle-based CDC to restart the GPU on each new pair, reply on done rising edge
    - program_memory.sv: patch the two operand MOV immediates (addr 1 -> R2 count,
    addr 3 -> R4 addend) with the live 6-bit operands
    - gpu.sv: thread operand_a/operand_b to the ROM
    - gpu.cst: constrain uart_rx_in to PIN 70
    - tb.sv: drive operands (5,3) so the self-check still expects 15
    - README: document the serial I/O
    Opera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
2026-05-31 Integrate 3x3 MAC unit as a GPU instruction (MACL / MAC)
    Make the CNN convolution MAC (mac_array_3x3.v, copied from the cnn project) a
    first-class functional unit in the GPU datapath:
    - decoder: new opcodes MACL (0110) and MAC (0111); new decoded_mac_load strobe
    and a MUX_MAC (2'b11) register-input selector
    - core: a core-level 18-byte operand buffer (9 pixels then 9 weights) filled one
    value per MACL from thread 0; instantiates mac_array_3x3; broadcasts result
    - registers: MAC write-back path (mux=MAC -> mac_result)
    - assembler: MACL Rs / MAC Rd, plus optional input/output file args
    - program_memory: KERNEL_HEX override so tests can load a different hex
    - software/conv_kernel.asm: worke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
2026-05-31 Add Host-to-Device data pipeline: UART RX -> DMA -> main memory (SRAM)
    - main_memory.sv: dual-port BRAM (DMA write port, GPU read port), 1024x8
    - dma_controller.sv: FSM that stores each rx_valid byte at an auto-incrementing
    write pointer, releases the port and pulses gpu_start after PAYLOAD_BYTES,
    then re-arms on gpu_done for the next frame
    - data_pipeline.sv: wires uart_rx + dma_controller + main_memory, exposes the
    read port for the GPU/testbench
    - test/tb_dma.sv: bit-bangs 793 UART frames (784-byte image + 9 weights), checks
    every byte lands sequentially in SRAM, the handshake fires, and the DMA re-arms
    Sim verified end-to-end. Not yet wired into the GPU (LSU read path is next).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
2026-05-31 Wire LSU read path: 4-way arbiter, GPU reads main memory, host-driven top
    - lsu_arbiter.sv: snapshot-and-drain arbiter serializing the 4 thread LSUs onto
    main_memory's single read port; latency hides inside the scheduler WAIT state
    - core.sv: instantiate the arbiter, connect all 4 LSUs (remove mem_ready=0 stub),
    expose the core's read port; set THREAD_ID(i) so %threadIdx is per-lane
    - gpu.sv: surface core 0's mem_raddr/mem_rdata
    - top.sv: restructured into a host-driven accelerator — data_pipeline + GPU on one
    clock, power-on auto-run removed, GPU idle until the DMA's gpu_start, done->gpu_done
    re-arm loop, result still reported over UART
    - software/ldr_kernel.asm + test/tb_ldr.sv: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
2026-06-01 Phase 1: wider data-memory addressing (base register + ADDB)
    Lets a kernel reach the whole image without ever loading a >6-bit constant:
    - decoder: new ADDB opcode (1001) + decoded_base_add strobe
    - lsu.sv: a 10-bit `base` pointer; ADDB does base += immediate; LDR address is
    now base + rs. Backward compatible (base resets to 0 -> addr = rs).
    - lsu_arbiter / core: widen the address path to ADDR_BITS (10) end to end
    - top.sv: expose CLK_FREQ/BAUD params so sims can stream at a fast baud
    - assembler: ADDB #imm
    - software/addr_kernel.asm + test/tb_addr.sv: walk base to 300 and LDR mem[300]
    (unreachable with an 8-bit register) -> R3 == streamed byte
    Full regression (multiply/MAC/DMA/LDR/conv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
    [addr_kernel.asm, core.sv, decoder.sv, lsu.sv, lsu_arbiter.sv, main.rs, tb_addr.sv, top.sv]
2026-06-01 Phase 2: full sliding-window convolution with memory-mapped UART emit
    The GPU now slides a 3x3 conv across a full 28x28 image and streams the 26x26
    feature map back over UART, host-driven end to end.
    - decoder: STR opcode (1011) -> decoded_mem_write
    - lsu.sv: STR write/emit FSM. STR to offset 63 routes data to the UART TX with
    an emit_valid/emit_ready handshake that stalls the scheduler until the byte is
    sent (flow control; no dropped outputs)
    - core/gpu/top: thread the emit path; top drives uart_tx with raw emit bytes and
    acks the GPU per byte (replaces the old done-result ASCII reporting)
    - uart_tx: BAUD_LIMIT is now a parameter (fast bit period in sim)
    - assembler: STR Rdata,[Raddr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
    [conv_full.asm, core.sv, decoder.sv, gpu.sv, lsu.sv, main.rs, tb.sv, tb_conv_full.sv]
2026-06-01 Make the core general-purpose: add MUL/SUB/SHR/SHL; keep MAC as opt-in coprocessor
    Addresses "this should be a general-purpose GPU, no baked operations." Multiply
    and shifts are now primitive ALU instructions the software composes, instead of
    only existing inside the fixed-function 3x3 MAC.
    - alu.sv: add MUL (rd=rs*rt, low 8b), SUB, SHR, SHL (shift by rt[2:0])
    - decoder.sv: opcodes MUL=1010, SHR=1100, SHL=1101, SUB=1110 (write rd via ALU)
    - assembler: MUL/SUB/SHR/SHL Rd,Rs,Rt
    - software/dotprod_kernel.asm + test/tb_dotprod.sv: a dot product (2*3 + 4*5 = 26)
    computed purely in software with MUL+ADD -- no MAC unit -- proving generality
    The 3x3 MAC (MACL/MAC) is retained as an explicit opti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
    [alu.sv, decoder.sv, dotprod_kernel.asm, main.rs, tb_dotprod.sv]
2026-06-01 Add mul_io demo kernel (stream two numbers, MUL, emit product)
    Hardware demo of the general-purpose core: LDR two operands from memory,
    multiply with the general MUL instruction, STR-emit the product. Verified on the
    Tang Nano 20K (e.g. 12*9=108, 15*15=225) host-driven over UART.
2026-06-01 added mnist assembly kernel draft
2026-06-03 Full-MNIST datapath: 4KB BRAM, FC-MAC coprocessor, two-pass assembler, mnist.asm
    Core/UART already run at native 27 MHz (no dividers in src/). Build out the
    datapath needed for an on-chip MNIST classifier:
    - Memory: widen main_memory ADDR_BITS 10->12 (1KB->4KB) parametrically across
    main_memory/data_pipeline/dma_controller/gpu/core/lsu/lsu_arbiter/top. Maps a
    2nd BSRAM block (1->2) to hold the 1690 FC weights + image + scratch.
    - FC-MAC coprocessor (src/fc_mac.sv): 32-bit signed accumulator with FCLR/FMAC/
    FRD under the free opcode 0000, wired into core via the MAC writeback mux, so
    169-term signed FC sums don't overflow the 8-bit datapath. Maps to DSP.
    - Decoder: decode opcode 0000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
2026-06-03 Integrate cnn_chip trained MNIST model: wide FC-MAC argmax + reference verify
    The cnn_chip Gowin project's trained model matches tiny-gpu's architecture
    (same single 3x3 filter, 169->10 FC, identical mac_array_3x3). Adopt its weights
    and make the FC-MAC coprocessor reproduce cnn_chip's fc_layer exactly.
    - fc_mac.sv: replace the lossy FRD>>Q readout with cnn_chip's scheme — a 32-bit
    signed accumulator, an int32 bias ROM ($readmemh bias.hex), and argmax in the
    full 32-bit domain. New ops under opcode 0000: FRST (reset engine), FMAC
    (acc+=px*wt), FARG (score=acc+bias[digit]; track best; digit++), FBEST
    (rd<-predicted digit). Decoder/core wire the new FARG sub-function.
    - Assembler: F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
    [core.sv, decoder.sv, fc_mac.sv, main.rs, mnist.asm, mnist_ref.py, tb_fc_mac.sv]
2026-06-03 MNIST FC classifier runs on the FPGA (on-chip inference, verified)
    End-to-end MNIST digit classification on the tiny-gpu core: stream the trained
    weights+features over UART -> DMA into memory -> FC sweep kernel runs 1690 MACs
    through the FC-MAC coprocessor (int32 bias + wide argmax) -> emits the digit.
    Confirmed on hardware: images 0/1/3/7/9 -> 7/2/0/9/9, all matching the reference.
    Conv+pool are precomputed off-line (mnist_ref.py) because the GPU LSU has no
    main-memory write path yet (STR only emits to UART), so feature maps can't be
    stored on-chip. Full conv->pool on the GPU is a follow-on needing an LSU store
    path + write arbitration.
    - decoder.sv: FIX — decoded_fc_arg was not cleared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
    [decoder.sv, mnist_fc.asm, mnist_ref.py, program_memory.sv, send_mnist.py, tb_mnist.sv, top.sv]
2026-06-03 LSU write path: GPU can now write data memory via STR (+ write base)
    Give the core physical write capability so intermediate feature maps can live
    on-chip (toward full conv->pool->FC on the GPU):
    - lsu.sv: add a write base (wbase) and a real write port. STR to a non-MMIO
    offset now commits mem[wbase+rs] <= rt (was a no-op); STR to offset 63 still
    emits to UART. wbase advances with the new WBASE op.
    - decoder.sv: WBASE = ADDB opcode (1001) with instruction[11] set -> routes to
    wbase (decoded_wbase_add); no new opcode consumed.
    - core.sv / gpu.sv: surface thread 0's write port (mem_we/waddr/wdata); writes
    are SIMT-uniform thread-0 (like emit), so the read arbiter is unchanged.
    - data_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
2026-06-03 Full on-chip MNIST pipeline (Conv->Pool->Scatter->FC) — verified in sim, runs on FPGA
    The whole CNN now runs on the tiny-gpu: stream a 784-byte image, get the digit
    back. No laptop precompute. Weights/biases baked; the GPU computes everything.
    HARDWARE additions (build on the LSU write path):
    - core.sv: bake the 9 conv weights into the MAC coprocessor (pixels-only MAC
    buffer); fixes the conv two-region-read problem (no weight reloads per window).
    - decoder.sv: FIX decoded_fc_arg not cleared in the per-decode block (latched
    high after the first FARG). Wire WBASE (write base) + FARG.
    - ADDR_BITS 12->13 (8 KB) across the memory chain; main_memory bakes the FC
    interleaved buffer (weight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
    [core.sv, data_pipeline.sv, dma_controller.sv, gpu.sv, lsu.sv, lsu_arbiter.sv, main_memory.sv, mnist_full.asm]
2026-06-03 Fix multi-run re-arm: DMA re-arms on a rising edge of gpu_done
    The full-pipeline kernel computed the first streamed image correctly but
    returned that same (stale) result for every subsequent image until a reflash.
    Root cause: gpu_done is a LEVEL that stays high after a run (the GPU sits in its
    done state until the next run resets it). dma_controller's S_RUN re-armed on the
    level `if (gpu_done)`, so the moment it entered S_RUN for the next run -- with the
    previous run's done still high -- it bounced straight back to S_LOAD, raising
    `loading` and routing the memory write port to the (idle) DMA. That blocked the
    new run's conv/pool/scatter writes, so it recomputed on the previous run's stale
    f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
    [dma_controller.sv, tb_full_img1.sv, tb_rearm.sv]
2026-06-03 README: document the on-chip MNIST CNN + current FPGA utilization
    Rewrite the README to reflect what the project actually is now: a minimal SIMT
    GPU running a full trained MNIST CNN (Conv->Pool->FC->argmax) end-to-end on the
    Tang Nano, image streamed in over UART, predicted digit returned. Adds the
    pipeline diagram, data-memory map, the current 16-bit ISA (FC-MAC, write path,
    WBASE, MAX), an honest scope statement, build/run steps, and a fresh post-P&R
    utilization table (Logic 8%, BSRAM 11%, DSP 25%, Fmax ~77.6 MHz, 0 violations).
    Replaces the stale 5*3 / ASCII-multiply writeup.
2026-06-03 README: add a practical Flashing guide (recipe + FT2232 recovery)
    Document what we learned the hard way: the two USB-serial ports (JTAG vs UART),
    openFPGALoader vs the bundled programmer_cli, the absolute-FS-path requirement,
    what a successful flash looks like (Status Code 0x6020 / ~5-7s), and a recovery
    table for the FT2232 wedging (replug, one clean attempt, don't hammer it).
2026-06-03 docs: roadmap for usable thread IDs + second-core feasibility check
    Part 1: plan to make per-thread IDs usable (they exist in HW as R13-15 but are
    unaddressable since reg fields are 3-bit). Approach: a MOV-variant (TID/BID/BDIM)
    that reads an identity reg into R0-R7, mirroring how WBASE overloaded ADDB; then
    per-thread addressing so the 4 lanes process distinct data.
    Part 2: feasibility check (no code) for a 2nd compute core. core_1 is already
    scaffolded but pruned (netlist has 1 MAC). Resource estimate: ~15% logic, ~50%
    DSP, ~11% BSRAM for two cores -> fits and should close 27 MHz. Verdict YES on
    capacity; the real cost is cross-core memory arbitration + work partitioning.
2026-06-05 demo: draw a digit in the browser, recognize it on the FPGA
    Self-contained, stdlib-only web demo. demo/index.html is a drawing canvas with
    MNIST-style preprocessing (bounding-box crop -> fit 20px -> center in 28x28).
    demo/server.py serves it and bridges /predict to the board over UART (reusing the
    macOS IOSSIOSPEED baud path), streaming 784 bytes and returning the predicted
    digit. Verified end-to-end over HTTP: image0->7, image1->2, image7->9.
    Run: python3 demo/server.py ; open http://localhost:8000
2026-06-14 Add usable per-thread IDs (TID/BID/BDIM) for real SIMT + architecture diagram
    The 4 thread lanes already carried unique identity registers (R15=threadIdx,
    R13=blockIdx, R14=blockDim) but no instruction could read them, so every lane
    ran identical work. Add TID/BID/BDIM as a MOV-variant (the unused rs field
    selects the identity register) so a kernel can pull threadIdx into an
    addressable register and the lanes finally diverge.
    - decoder.sv: new decoded_id_read strobe, set on MOV with rs != 0
    - registers.sv: on id_read, write registers[15/13/14] selected by rs
    - core.sv: thread the strobe through to each lane's register file
    - assembler (main.rs): TID/BID/BDIM mnemonics
    - kernels: tid_demo.as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
2026-06-15 docs: fix architecture diagram — render full two-core overview
    The embedded docs/gpu_overview.png was a stale render of an older
    single-core SVG: only compute_core_0 and a cropped dispatcher showed,
    contradicting the README's "two SIMT cores" description. Re-render from
    the current gpu_overview.svg (1720x800 @2x = 3440x1600) so both cores,
    the dispatcher, memory/UART chain, output row, and resource footer all
    appear.
2026-06-15 docs: add per-core architecture diagram above the full-chip overview
    The Architecture section now leads with a detailed single-core view
    (core.sv: warp scheduler/decoder, four thread lanes with their own
    registers/ALU/LSU/PC, the shared LSU arbiter, and the conv/FC MAC
    coprocessors) and follows it with the existing whole-chip overview.
    New docs/core_detail.svg rendered to docs/core_detail.png.
2026-06-22 feat: implement multi-warp scheduler with stack-based control flow divergence and context switching support
    [core.sv, data_pipeline.sv, decoder.sv, dma_controller.sv, fc_mac.sv, gpu.sv, lsu.sv, pc.sv]
2026-06-22 fix: align datapath to 4-bit pipeline state + fix multi-warp arbiter width
    The multi-warp scheduler widened core_state from 3 to 4 bits (to insert the
    SELECT_WARP stage), but core.sv and the datapath modules still treated it as
    3-bit with the old stage numbers — so every module fired in the wrong pipeline
    stage and nothing executed. Widen core_state to [3:0] in core/decoder/registers/
    pc/lsu and renumber the stage constants to match scheduler.sv.
    Also rewrite lsu_arbiter: svc/sel were hardcoded 2-bit (4 threads), so with two
    warps (8 threads) warp 1's requests were never serviced, deadlocking on any LDR.
    Replace with a width-correct ($clog2) continuously-serving arbiter.
    With these fixes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
    [core.sv, decoder.sv, lsu.sv, lsu_arbiter.sv, pc.sv, registers.sv]
2026-06-22 fix: resolve load-use hazard in multi-warp LSU (loads no longer lag)
    The reworked LSU formed the memory address (base + rs) during the REQUEST
    stage, but the register file only latches rs AT REQUEST, so rs is valid one
    cycle later. Every load therefore used the previous instruction's operand,
    making each LDR result land one instruction too late — the dependent ADD read a
    stale value and the final term was dropped (sum 70 instead of 100).
    Insert a deferred-issue state (lsu_state 01): wake at REQUEST to capture
    read/write intent, then form the address/data the next cycle when rs/rt are
    valid. The scheduler already treats lsu_state 01 as "waiting", so the
    park/context-switch behaviour is pre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
    [lsu.sv]
2026-06-22 fix: correct multi-warp emit routing + ordering (sim now passes)
    Two emit bugs surfaced once the compute was correct:
    1. Routing: core.sv drove the UART from lsu_emit_valid[current_warp], so a
    context switch mid-handshake misrouted/dropped the byte (reply was garbage).
    Add an emit-ownership latch: one warp holds the UART until its byte is acked,
    and emit_ready is steered only to that owner.
    2. Ordering: the scheduler treated a UART emit like a memory wait and yielded,
    so the two warps' [len][sum] frames interleaved (01 01 64 64 instead of
    01 64 01 64). A UART write has no latency to hide, so STALL on the emitting
    warp instead of yielding (new warp_emit signal + warp_issui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
    [core.sv, scheduler.sv]
2026-06-22 test: validate per-lane SIMT branch divergence (PASS)
    Add SYNC mnemonic to the assembler (RET|1 -> decoded_sync, pops the warp's
    reconvergence stack) and a divergence validation kernel + testbench.
    divergence_kernel.asm makes each lane branch on its OWN threadIdx:
    lanes 0,1 (threadIdx<2) take the branch -> R3=10
    lanes 2,3 (threadIdx>=2) fall through -> R3=20
    The 4 lanes therefore execute different instructions in lockstep. tb_divergence
    reads each lane's R3 by hierarchical reference (only thread 0 can emit) and
    checks R3 = [10,10,20,20]. If divergence were broken (all lanes follow lane 0)
    every lane would read 10, so the test distinguishes working from broken.
    `make sim-divergence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
    [divergence_kernel.asm, main.rs, tb_divergence.sv]
2026-06-22 fix+test: restore mask on reconvergence so post-merge code runs on all lanes
    Validation found that divergence worked (lanes take different paths) but
    RECONVERGENCE did not: when the divergence stack emptied on SYNC, the scheduler
    advanced the PC but left active_mask at the last-popped subset, so common code
    after a merge only ran for some lanes (R4 = [0,0,7,7] instead of [7,7,7,7]).
    Fix: remember the pre-divergence mask (base_mask, captured at the outermost
    divergence) and restore it when the stack empties. Single-level diamonds now
    reconverge to the full lane set. (Nested divergence reconvergence is a known
    further limitation — would need the join pushed on the stack.)
    Add divmerge_kern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
    [divmerge_kernel.asm, scheduler.sv, tb_divmerge.sv]
2026-06-23 feat: NVIDIA-style launch bounds so warps stop running the same kernel
    Both warps previously launched the same kernel with identical thread IDs
    (both 0-3) and blockDim=4, so warp 1 redundantly duplicated warp 0's work.
    Add a BLOCK_DIM parameter threaded top->gpu->core->scheduler+registers:
    - threadIdx is now GLOBAL (core.sv: THREAD_ID = w*THREADS_PER_BLOCK + i),
    so warp0=0-3 and warp1=4-7 cover distinct threads.
    - registers R14 (%blockDim) reports the launch size, not the warp size.
    - scheduler reset presets warps past BLOCK_DIM to WARP_DONE and masks
    partial-warp lanes, so a 4-thread kernel launches exactly one warp.
    Default BLOCK_DIM=4: every existing kernel now runs one warp (redund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
    [core.sv, gpu.sv, registers.sv, scheduler.sv, tb_warps.sv, top.sv]
2026-06-23 feat: read the full 32-bit MAC result via MAC Rd,#n byte-select
    The MAC/FC units accumulate in 32 bits but the register file is 8-bit, so
    core.sv truncated every result to its low byte. Add a 2-bit byte index in the
    free [1:0] encoding bits: MAC Rd,#n writes byte n (0=LSB..3=MSB) of the 32-bit
    result; bare MAC Rd stays byte 0 (backward compatible, no new opcode).
    - decoder.sv: emit decoded_mac_byte[1:0] from instruction[1:0] in the MAC case
    - core.sv: 4:1 byte mux on the shared 32-bit mac_or_fc_result_32 (decoded_fc_read
    still selects FC vs conv); the [7:0] truncation is gone
    - main.rs: MAC arm takes an optional #n immediate
    - mac_read32.asm + tb_mac32.sv + `make sim-mac32`: compute 8*30*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
2026-06-23 build: bring the multi-warp GPU up on real hardware via the open-source flow
    Gowin's proprietary GowinSynthesis SIGSEGVs inferring main_memory's block RAM on
    the current multi-warp design (crash in RamInference::transReductionNor2Decoder;
    no syn_ramstyle support to opt out). Build with the open-source toolchain instead
    -- a different synthesizer with no such bug:
    sv2v -> yosys/synth_gowin -> nextpnr-himbaechel -> gowin_pack (apicula)
    - oss_build/run_oss.sh: the working flow (set OSS_CAD_SUITE; nextpnr needs
    --vopt family=GW2A-18C; gowin_pack -d GW2A-18C). 40% LUT, Fmax ~67MHz.
    - Makefile: `make build-oss` / `make flash-oss`.
    - software/send_kernel.py: host loader streaming [header][pr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
    [core.sv, program_memory.sv, registers.sv, scheduler.sv, send_kernel.py]
2026-06-23 feat: default to 2 warps per block (BLOCK_DIM=8) + fix stale MAC comments
    - top.sv / gpu.sv: BLOCK_DIM default 4 -> 8, so each core now launches 2 warps
    (8 threads, global IDs warp0=0..3, warp1=4..7) instead of one. WARPS_PER_CORE
    was already 2; this fills both slots by default.
    - core.sv: corrected the stale "3x3 / 9 pixels / 18 operands / baked weights"
    comments on the MAC unit. It is a STATIC 8-lane MAC (vector_mac.sv) fed by
    MACL-pushed (pixel,weight) PAIRS; fc_mac is the arbitrary-length accumulator.
    Consequence (expected for 2 active warps): single-result kernels emit one frame
    per warp, so lane 0 of both warps hits the UART. Verified on hardware (OSS build,
    make build-oss/fla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
    [core.sv, gpu.sv, top.sv]
2026-06-23 feat: run the GPU at 81 MHz (27x3 via rPLL) over the open-source flow
    Bring the multi-warp GPU up at a real system clock instead of the 27 MHz
    crystal, and fix the two bugs that were blocking it. Mul kernel verified
    correct on hardware at 81 MHz (7x6, 9x9, 12x10, 13x11, 15x15).
    The root cause was NOT the PLL: src/uart_tx.sv used `reg [7:0] clock_count`
    (max 255), but at a multiplied clock BAUD_LIMIT = CLK_FREQ/115200 exceeds 255
    (468 at 54 MHz, 703 at 81 MHz), so `clock_count < BAUD_LIMIT-1` was always true
    and the transmit bit period never completed -> every result emitted as garbage.
    uart_rx already used a 16-bit tick, so receive worked (programs loaded and the
    GPU computed correctly); on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
    [gowin_pll.sv, top.sv, uart_tx.sv]
2026-06-24 feat: scale to a 24-lane GPU (3x peak ops/s) + fix the reset critical path
    The design was timing-bound, not area-bound: at ~55% LUT it failed 81 MHz.
    Fixing the reset path then widening the SIMD gives a 24-ALU-lane GPU at 81 MHz.
    Timing (Fmax 79.5 -> 100 MHz, default build now routes at 136 MHz):
    - vector_mac: async reset (negedge rst_n) -> synchronous. The async CLEAR on the
    wide product regs was the critical-path endpoint; sync reset also lets yosys map
    the multipliers into hard DSP (MULT9X9) instead of fabric.
    - top.sv: register gpu_reset (was a high-fanout combinational POR/pll-lock net
    fanned out to every flop) so it starts from a flop with the full period.
    Scaling knobs made pa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
    [core.sv, gpu.sv, scheduler.sv, top.sv, vector_mac.sv, widthproof.asm]
2026-06-24 feat: per-lane memory writes (write arbiter) + a parallel MLP layer
    Unlocks the SIMT lanes for neural-net inference. Previously only thread 0 could
    write memory or emit (core.sv hardwired the write port to lane 0), so a layer
    could not produce one output per lane -- the wide GPU was useless for NN work.
    - src/lsu_write_arbiter.sv (new): serializes every lane's write onto main_memory's
    single write port, mirroring lsu_arbiter (reads). 1-cycle BRAM write, lowest-index
    picker, one-cycle grant mask to avoid a double grant on the registered handshake.
    - src/lsu.sv: memory-write path now raises a held we_req, waits in state 10 for the
    arbiter's wgrant, then DONE (mirrors the read path). Emi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
    [core.sv, lsu.sv, lsu_write_arbiter.sv, mlp_parallel.asm, tb_mlp.sv]
2026-06-24 Enhance README with architecture and functionality details
    Expanded the README to include details about the dual-core architecture, context switching, and coprocessors.
2026-06-24 perf: trim the scheduler FSM (7->6 cycles) for compute ops to raise peak ops/s
    Peak ALU ops/s ~= NUM_CORES * THREADS_PER_BLOCK * f / cycles_per_instruction.
    Lanes are LUT-maxed (18) and the clock is rPLL-limited to 81 MHz, so the remaining
    lever is cycles/instruction.
    - scheduler.sv: a compute-only instruction never touches the LSU, so its WAIT state
    is pure pass-through. REQUEST now goes (decoded_mem_op ? WAIT : EXECUTE), dropping
    non-memory instructions from 7 cycles to 6 (~1.17x). REQUEST itself is kept: the
    registered decoder makes rs/rt addresses valid only at REQUEST, and registers.sv
    latches rs/rt there -- skipping it starves the ALU (verified: sims fail). With the
    latch at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
    [core.sv, gowin_pll.sv, scheduler.sv, top.sv]
2026-06-24 test: measure real ALU ops/s on hardware (~228 M ops/s)
    Adds an empirical throughput benchmark so the peak-ops/s figure is measured, not
    just the lanes x clock / cycles ceiling.
    - software/bench_ops.asm: nested-loop kernel, 16-pure-ALU-op body (takes the
    6-cycle path), uniform loop bound (no divergence). Outer count comes from mem[0]
    so the program is byte-identical across runs.
    - software/bench_host.py (make bench): times several outer counts and fits the
    SLOPE of wall-clock vs outer. The slope is pure GPU compute time -- the ~13 ms of
    fixed UART load/reply/ramp overhead lands in the intercept and cancels out.
    Result on the Tang Nano 20K (18-lane, 81 MHz, FSM-trim bitstream):
    22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
    [bench_host.py, bench_ops.asm]
2026-06-29 feat: J++ language + compiler (lexer/parser/codegen) lowering to tiny-gpu asm
    Rebuild of the high-level compiler from scratch as J++. Pipeline:
    source -> lexer -> parser (AST) -> codegen -> .asm -> assembler -> .hex
    -> send_kernel.py -> FPGA. HW-validated end to end on the Tang Nano 20K.
    - software/src/{token,lexer,ast,parser,codegen}.rs + bin/jpp.rs (lib via lib.rs);
    assembler (main.rs) stays the default cargo binary.
    - Keywords: JoseIgnacioVariable (declare), JoseIgnacioLoop (while), JoseIgnacioYeet
    (emit to UART); // line comments; 8-bit numbers; + - < ==.
    - Codegen: R0-R5 vars, R6/R7 scratch; trailing double-RET to survive the UART
    loader's last-word drop.
    - Assembler: restored BR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
2026-07-04 feat(jpp): add tid/bid/bdim SIMT identity reads to J++
    New Expr::ThreadId lowers to the TID/BID/BDIM ops the assembler already
    had, so J++ kernels can now do per-lane work. Recognized as bare-word
    operands (same path as mem[]), no lexer/token changes. tid_demo.jpp is
    the proof; README J++ list updated.
2026-07-04 feat(jpp): AI demo — a neuron in J++, and fix main not compiling
    Extends crunch_push to a (pixel, weight) pair (MACL rs,rt) so J++ can
    express a real weighted neuron; nn.jpp is an 8-tap dot product on the
    vector_mac accelerator, verified by tb_nn.sv / `make sim-nn` (computes 64).
    Also: MemoryAccess loads in place to save a scratch register, and Comma
    token added.
    Commits the J++ keyword rebuild (lexer/token: manifest/grind_until/
    crunch_*) that was uncommitted — a prior commit pushed parser.rs
    referencing these tokens without their definitions, leaving main
    uncompilable. This restores a building tree.
    [ast.rs, lexer.rs, main.rs, parser.rs, tb_nn.sv, token.rs]
2026-07-04 feat: MNIST classifier in J++, hardware-validated
    The MNIST fully-connected classifier now runs from J++ source on the
    Tang Nano 20K and predicts 7 on image 0 (07 07, both cores). Also passes
    in sim via `make sim-mnist-jpp`.
    J++ compiler additions (all keyword -> existing-op lowerings):
    - fc_reset/fc_mac/fc_finalize/fc_best -> FRST/FMAC/FARG/FBEST
    - advance -> ADDB #1 (base-pointer streaming for payloads > 8-bit range)
    - mnist_fc.jpp: the classifier (10 digits x 169 FMAC + bias + argmax)
    Supporting:
    - fc_mac.sv: restore argmax + int32 bias ROM (FBEST read raw score without
    it; required for correct predictions — the stale bitstream returned 183)
    - tb_mnist_loadrun.sv fixed to 1 warp + c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
    [ast.rs, fc_mac.sv, lexer.rs, parser.rs, send_kernel.py, tb_mnist.sv, tb_mnist_jpp.sv]
2026-07-04 feat: jpp — REPL/runner to type J++ and run it on the FPGA
    `./jpp` opens a REPL (type code, /run to execute on the board, /quit);
    `./jpp file.jpp` compiles+runs a file. Wraps the J++ compiler + assembler
    + send_kernel so there's no hex or python to invoke by hand. Prints just
    the reply (e.g. "→ 8 8", one byte per core).
2026-07-23 feat: drills — Verilog interview practice problems
    [01_counter.sv, 02_edge.sv, 03_alu.sv, 04_shift.sv, 05_fsm.sv, 06_fifo.sv, tb_01_counter.sv, tb_02_edge.sv]
2026-07-23 chore: build/infra + PLL 54 MHz + DMA demo server
2026-09-16 feat: real ML compiler — multi-layer int8 inference, model out of the bitstream
    Turns the toolchain from "one hand-written MNIST kernel" into a compiler that
    takes a quantized graph and produces a data image + kernel. HW-validated on the
    Tang Nano: the 2-layer MLP's 10 scores and prediction match the reference
    byte-for-byte on both cores.
    Two things blocked multi-layer inference, both in hardware:
    FACC Rd,#n reads byte n of the raw 32-bit FC accumulator. fc_mac's only
    output was best_idx, so a hidden layer could not see its own
    pre-activation at all.
    FOUT Rd,#t clamp(acc >>> (8+t), 0, 255), then clears acc. Requantize +
    saturate + ReLU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
2026-09-17 feat(mlc): SSA graph IR frontend + legalize/fuse pass in graph_compiler
    export_model.py now emits {tensors, nodes} instead of pre-lowered layers[].
    graph_compiler legalizes {Linear, Relu, Argmax}, fuses Linear->Relu (and
    Linear->Argmax) into one FMAC loop + FOUT, then plans/lowers as before.
    Output is byte-identical to the layers[] flow; sim-mlp2 PASS, run-mlp2
    bit-exact on both cores.
2026-09-17 feat(mlc): torch frontend — nn.Module -> quantized SSA graph
    export_torch.py traces forward() with torch.fx, rejects bias / unsupported
    ops by name, quantizes weights to int8 and calibrates one FOUT shift per
    Linear on training data, then emits {tensors, nodes} for graph_compiler.
    A bit-exact integer reference reports chip accuracy before anything is flashed.
    169->32->10 bias-free MLP on 13x13 MNIST: float 93.41%, chip-exact int8
    93.43%. make run-mlp2 MODEL=mnist_mlp IMAGE=0..9: all 10 bit-exact on the
    board (both cores), 9/10 correct (img 8 is a model error, same in reference).
    [export_torch.py]
2026-09-17 feat(mlc): Conv2d + MaxPool2d + Flatten — a PyTorch CNN compiles to the chip
    graph_compiler lowers Conv2d(1->C, KxK, stride 1)+Relu to an unrolled KxK
    FMAC window walk + FOUT (weights from data memory, nothing baked), MaxPool2d
    (kxk, stride k) to LDR + MAX, Flatten to nothing. Each layer kind has its own
    plan size, codegen and bit-exact eval; wide pointer steps fall back to LDI+ADD.
    Legalize rejects cin>1, stride/padding, conv without Relu, Linear without
    Flatten, and out-of-memory by name. MLP output is byte-identical.
    export_torch.py captures Conv2d/MaxPool2d/Flatten via torch.fx + ShapeProp,
    calibrates conv shifts, and adds mnist_cnn: conv3x3(1->2) -> relu -> maxpool2
    -> flatten -> lin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
2026-09-17 test(mlc): differential fuzzer — random graphs, compiler vs RTL, bit-exact
    software/fuzz_mlc.py generates random graphs (Conv2d/MaxPool2d/Flatten/
    Linear chains, random shapes, int8 weight and u8 input distributions,
    mostly-calibrated shifts, some graphs ending right after conv/pool so every
    activation is observable) and checks each case three ways:
    graph reference (Python, from the graph alone) == graph_compiler eval ==
    RTL (test/tb_mlc.sv, the board's 1-warp/9-lane config, one compile for all
    models via plusargs). make fuzz [FUZZ_N=200] [FUZZ_SEED=1].
    Mutation-tested: planted RTL FOUT-shift, reference-shift, conv-step and
    pool-step bugs are all caught (17/24, 17/24, 4/24, 1/24 cases at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
    [tb_mlc.sv]
2026-09-21 docs: TO-DO.MD as a handoff — current state, what needs the board, ranked next steps
    The old note proposed READ_HIGH/READ_MID ops to pull the 32-bit MAC result out
    a byte at a time; FACC does that now, so it was stale.
    Replaces it with what another machine (or agent) needs to pick the work up:
    what the compiler pipeline is, which targets need the FPGA attached, the ranked
    next steps, and the gotchas that cost time.
    Claude-Session: https://claude.ai/code/session_011TnAp8jTQm2VrN31RWrvbs
2026-09-21 docs: correct the handoff note, and stop ignoring software/models/
    The note I committed one commit ago described the state as of `ml-compiler`
    and missed everything on `graph-ir` — the torch frontend, the SSA IR, conv/
    pool/flatten, and the fuzzer. Rewritten against what is actually there.
    Also un-ignores software/models/ (120 KB). That .gitignore line was fine when
    the models were seeded-random and regenerable from export_model.py, but they
    now hold trained torch checkpoints and the quantized graphs export_torch.py
    produces — so a fresh clone on a machine without torch got the compiler with
    nothing to compile. That is exactly the case this note is meant to serve.
    Two things the note n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
2026-09-29 feat(jpp): if, max, mul, and shifts, plus the MNIST CNN in J++
    Threads may take different branches. Constants above 63 use LDI,
    advance and wbase take a count, and crunch_fire selects a result byte.
